FlorianBaumgartner/WallLight/Bootloader/Flash-Offsets.PNG

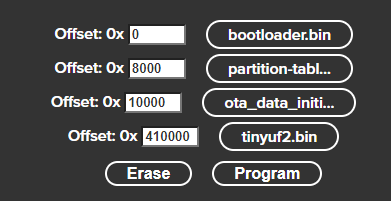
Bootloader/Flash-Offsets.PNG
