FlorianBaumgartner/WallLight/Software/flowpy/.assets/Flowpy_studio_example_flow.png

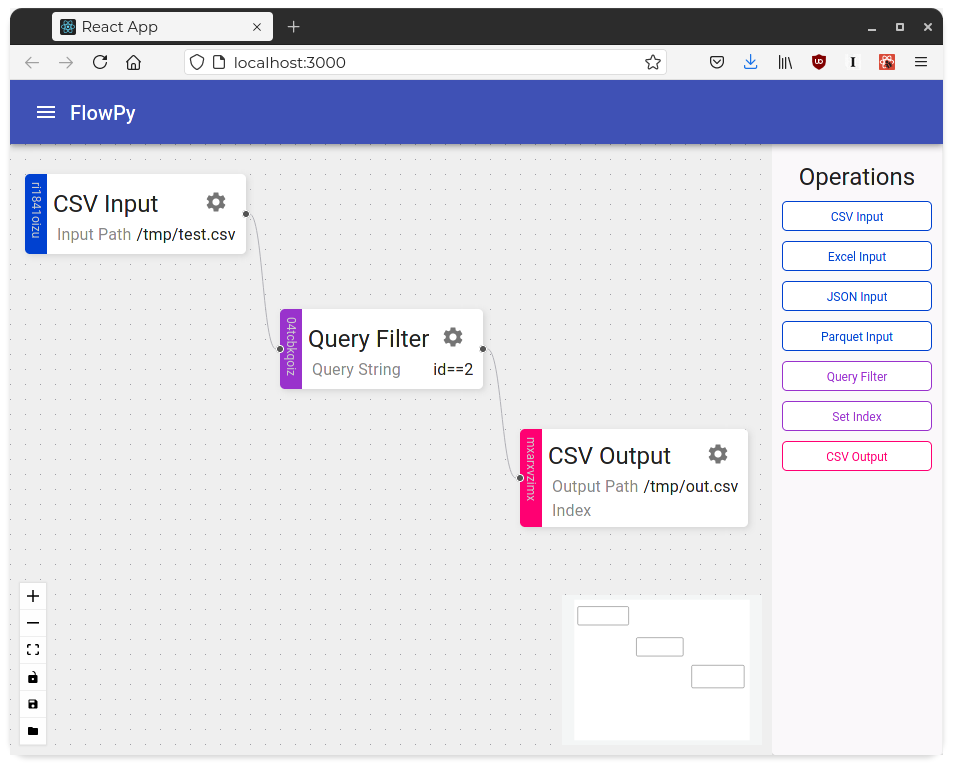
Software/flowpy/.assets/Flowpy_studio_example_flow.png
