FlorianBaumgartner/WallLight/Software/flowpy/.assets/Flowpy_studio_example_flows_list.png

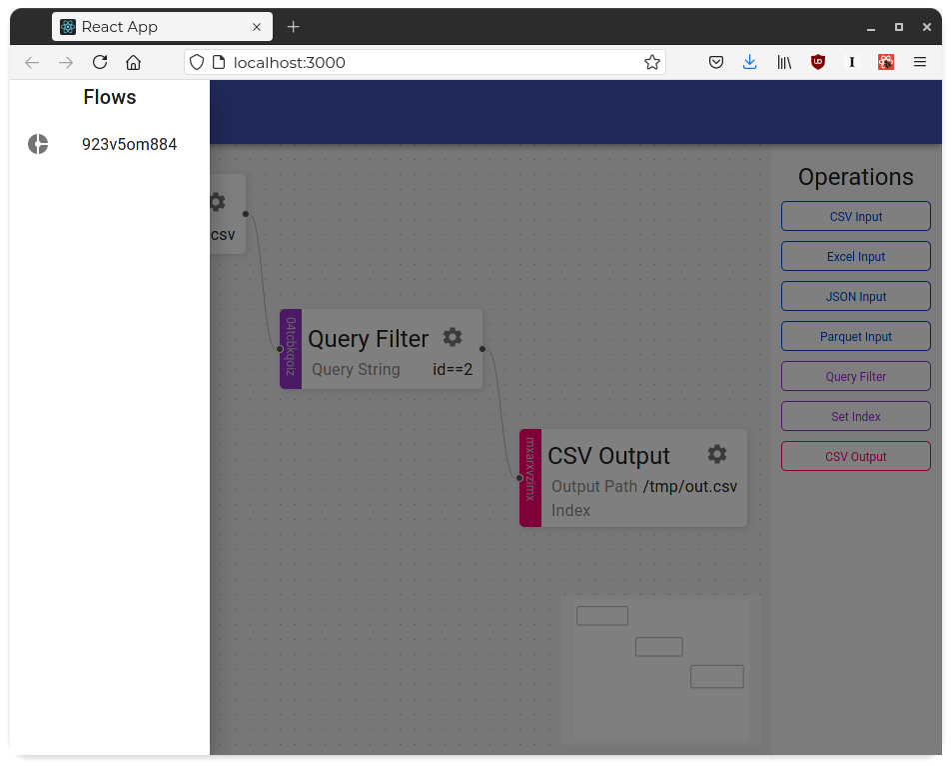
Software/flowpy/.assets/Flowpy_studio_example_flows_list.png
