FlorianBaumgartner/WallLight/Software/flowpy/.assets/Flowpy_studio_example_params.png

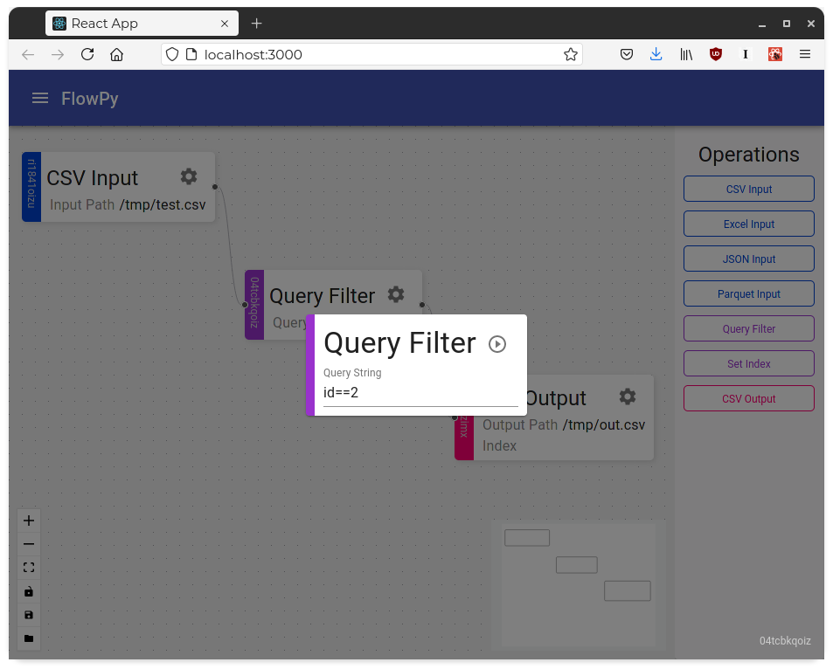
Software/flowpy/.assets/Flowpy_studio_example_params.png
