FlorianBaumgartner/WallLight/Software/flowpy/.assets/prealpha_api_node_run.png

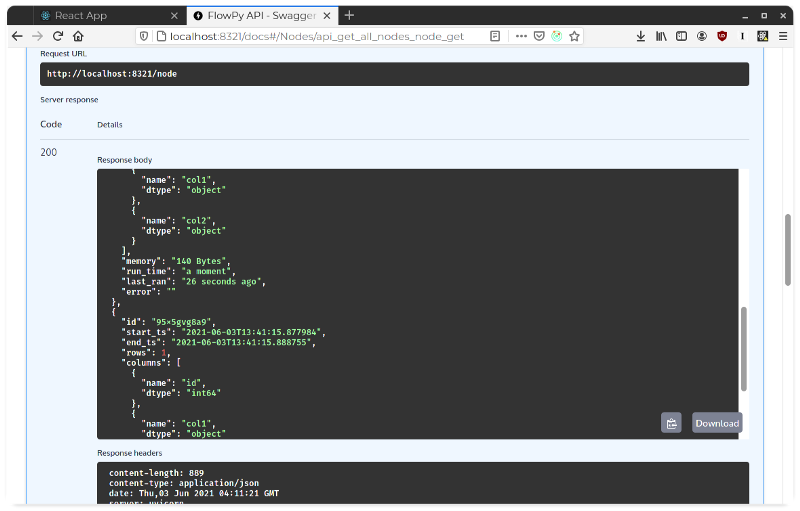
Software/flowpy/.assets/prealpha_api_node_run.png
