FlorianBaumgartner/WallLight/Software/flowpy/.assets/prealpha_ui.png

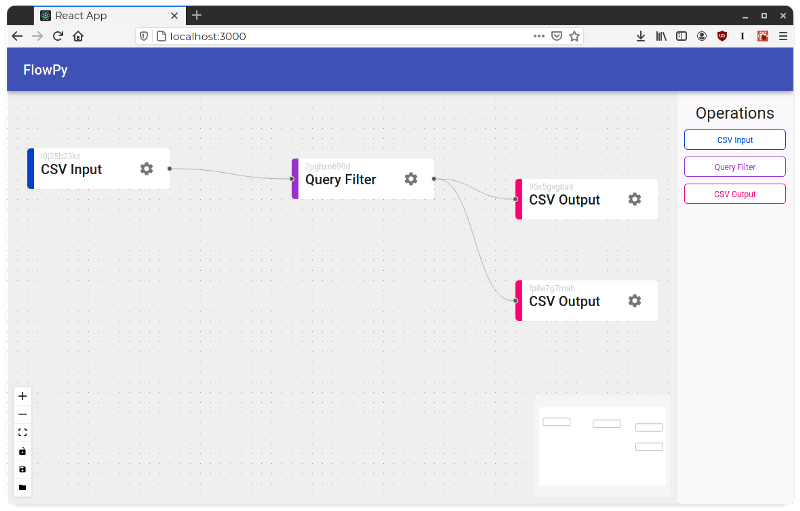
Software/flowpy/.assets/prealpha_ui.png
