FlorianBaumgartner/WallLight/Software/flowpy/.assets/prealpha_ui_node_settings.png

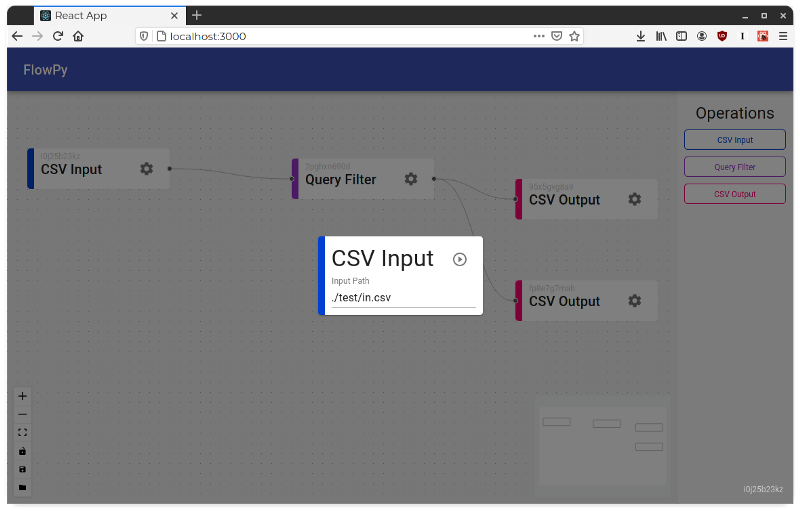
Software/flowpy/.assets/prealpha_ui_node_settings.png
