FlorianBaumgartner/WallLight/Software/TeensyGui/img/adat.jpg

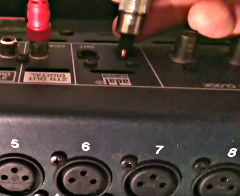
Software/TeensyGui/img/adat.jpg
