FlorianBaumgartner/WallLight/Software/TeensyGui/img/adccircuit2.png

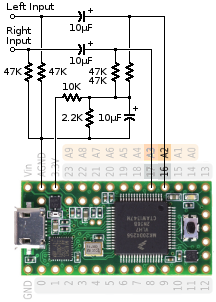
Software/TeensyGui/img/adccircuit2.png
