FlorianBaumgartner/WallLight/Software/TeensyGui/img/adccircuit.png

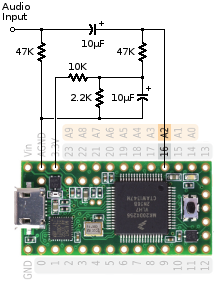
Software/TeensyGui/img/adccircuit.png
