FlorianBaumgartner/WallLight/Software/TeensyGui/img/adccircuitmic.jpg

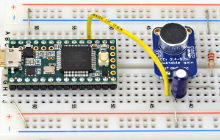
Software/TeensyGui/img/adccircuitmic.jpg
