FlorianBaumgartner/WallLight/Software/TeensyGui/img/adcpins1.jpg

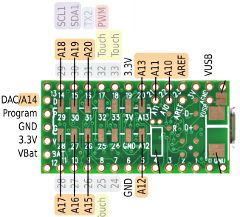
Software/TeensyGui/img/adcpins1.jpg
