FlorianBaumgartner/WallLight/Software/TeensyGui/img/adcpins2.jpg

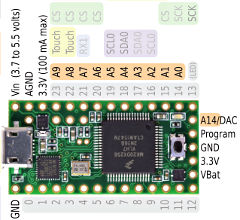
Software/TeensyGui/img/adcpins2.jpg
