FlorianBaumgartner/WallLight/Software/TeensyGui/img/ampschematics.png

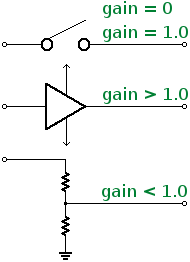
Software/TeensyGui/img/ampschematics.png
