FlorianBaumgartner/WallLight/Software/TeensyGui/img/audioshield_backside.jpg

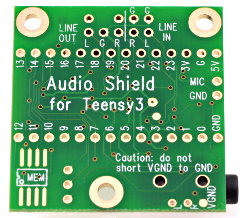
Software/TeensyGui/img/audioshield_backside.jpg
