FlorianBaumgartner/WallLight/Software/TeensyGui/img/audioshield_inputs.jpg

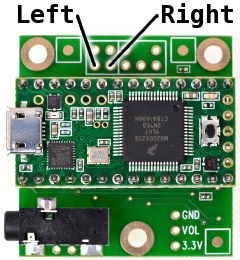
Software/TeensyGui/img/audioshield_inputs.jpg
