FlorianBaumgartner/WallLight/Software/TeensyGui/img/audioshield_outputs.jpg

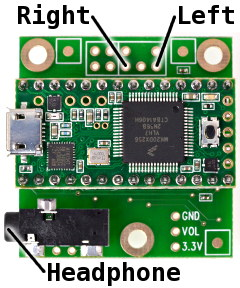
Software/TeensyGui/img/audioshield_outputs.jpg
