FlorianBaumgartner/WallLight/Software/TeensyGui/img/audioshield_quad_in.jpg

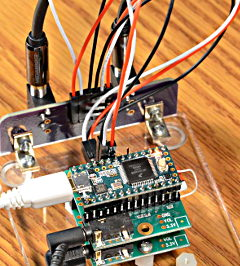
Software/TeensyGui/img/audioshield_quad_in.jpg
