FlorianBaumgartner/WallLight/Software/TeensyGui/img/audioshield_quad_out.jpg

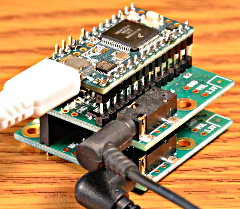
Software/TeensyGui/img/audioshield_quad_out.jpg
