FlorianBaumgartner/WallLight/Software/TeensyGui/img/biquad.png

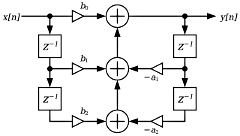
Software/TeensyGui/img/biquad.png
