FlorianBaumgartner/WallLight/Software/TeensyGui/img/cs42448.jpg

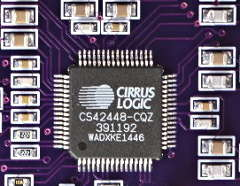
Software/TeensyGui/img/cs42448.jpg
