FlorianBaumgartner/WallLight/Software/TeensyGui/img/dac_speaker.jpg

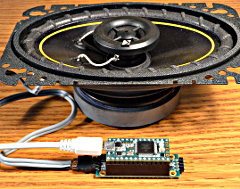
Software/TeensyGui/img/dac_speaker.jpg
