FlorianBaumgartner/WallLight/Software/TeensyGui/img/dacpin.jpg

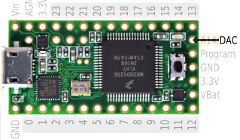
Software/TeensyGui/img/dacpin.jpg
