FlorianBaumgartner/WallLight/Software/TeensyGui/img/dacpins.png

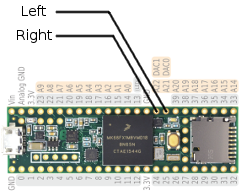
Software/TeensyGui/img/dacpins.png
