FlorianBaumgartner/WallLight/Software/TeensyGui/img/dahdsr.png

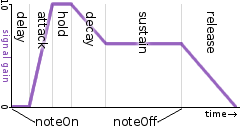
Software/TeensyGui/img/dahdsr.png
