FlorianBaumgartner/WallLight/Software/TeensyGui/img/delay.png

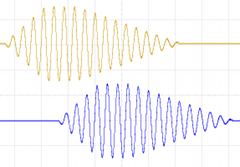
Software/TeensyGui/img/delay.png
