FlorianBaumgartner/WallLight/Software/TeensyGui/img/ladder.png

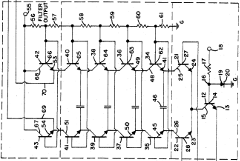
Software/TeensyGui/img/ladder.png
