FlorianBaumgartner/WallLight/Software/TeensyGui/img/memoryboard.jpg

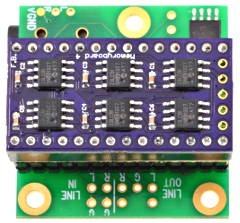
Software/TeensyGui/img/memoryboard.jpg
