FlorianBaumgartner/WallLight/Software/TeensyGui/img/multiply.png

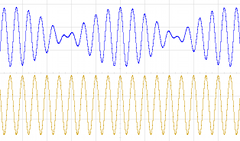
Software/TeensyGui/img/multiply.png
