FlorianBaumgartner/WallLight/Software/TeensyGui/img/pt8211.jpg

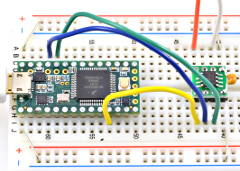
Software/TeensyGui/img/pt8211.jpg
