FlorianBaumgartner/WallLight/Software/TeensyGui/img/pwm.png

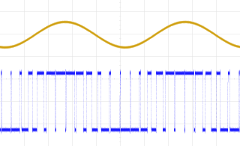
Software/TeensyGui/img/pwm.png
