FlorianBaumgartner/WallLight/Software/TeensyGui/img/pwmdualcircuit.jpg

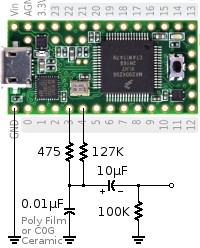
Software/TeensyGui/img/pwmdualcircuit.jpg
