FlorianBaumgartner/WallLight/Software/TeensyGui/img/sgtl5000closeup.jpg

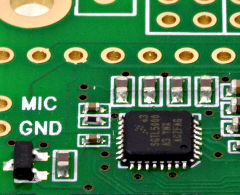
Software/TeensyGui/img/sgtl5000closeup.jpg
