FlorianBaumgartner/WallLight/Software/TeensyGui/img/shelf_filter.png

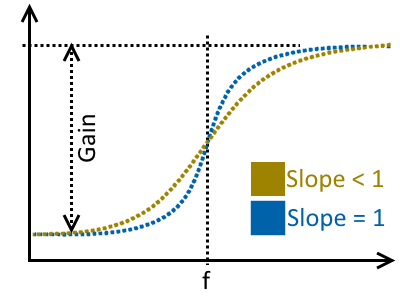
Software/TeensyGui/img/shelf_filter.png
