FlorianBaumgartner/WallLight/Software/TeensyGui/img/spdif_proto.jpg

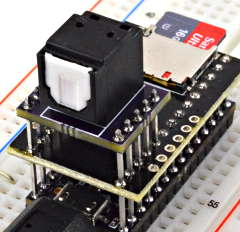
Software/TeensyGui/img/spdif_proto.jpg
