FlorianBaumgartner/WallLight/Software/TeensyGui/img/tdm.jpg

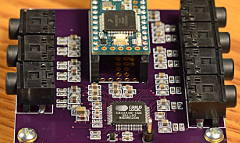
Software/TeensyGui/img/tdm.jpg
