FlorianBaumgartner/WallLight/Software/TeensyGui/img/touchguitar.jpg

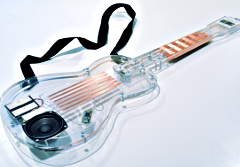
Software/TeensyGui/img/touchguitar.jpg
