FlorianBaumgartner/WallLight/Software/TeensyGui/img/usbtype_audio.png

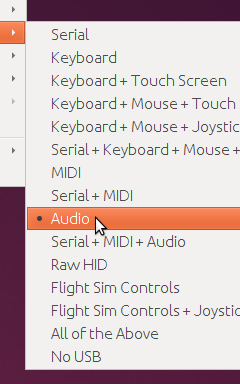
Software/TeensyGui/img/usbtype_audio.png
