FlorianBaumgartner/WallLight/Software/TeensyGui/img/usbtype_audio_in.png

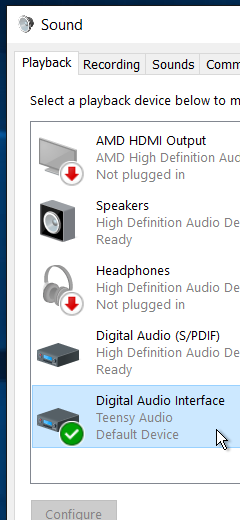
Software/TeensyGui/img/usbtype_audio_in.png
