FlorianBaumgartner/WallLight/Software/TeensyGui/img/usbtype_audio_out.png

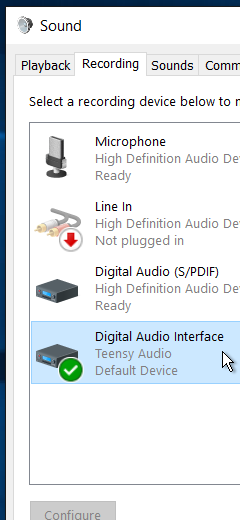
Software/TeensyGui/img/usbtype_audio_out.png
