FlorianBaumgartner/WallLight/Software/TeensyGui/img/w25q128fv.jpg

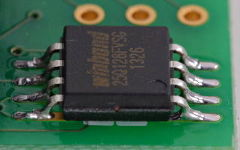
Software/TeensyGui/img/w25q128fv.jpg
