FlorianBaumgartner/WallLight/Software/TeensyGui/img/wavefolder.png

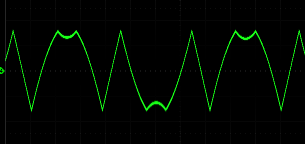
Software/TeensyGui/img/wavefolder.png
