FlorianBaumgartner/WallLight/Software/TeensyGui/img/waveforms.png

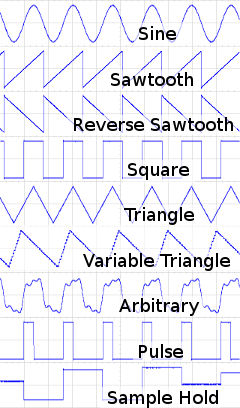
Software/TeensyGui/img/waveforms.png
