FlorianBaumgartner/WallLight/Software/TeensyGui/img/waveformsmod.png

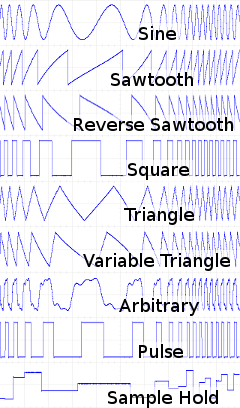
Software/TeensyGui/img/waveformsmod.png
