FlorianBaumgartner/WallLight/Software/TeensyGui/img/waveshaper.png

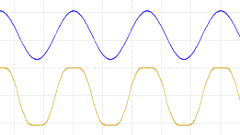
Software/TeensyGui/img/waveshaper.png
