FlorianBaumgartner/WallLight/Software/TeensyGui/img/wavetablevideo.jpg

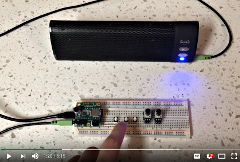
Software/TeensyGui/img/wavetablevideo.jpg
