FlorianBaumgartner/WallLight/Hardware/WallLightRemote/Project Logs for WallLightRemote/WallLightRemote_V1.0 BOM.xlsx

Comment | Designator | Footprint | LCSC Part Number
SLDA72-2R470G-S1TF (2.47GHz) | A1 | SMD Chip-Antenna 7020 (SLDA72-2R470G-S1TF) | C370399
100µF 6.3V | C1, C26, C29 | SMD Tantalkondensator 1210 + | C16133
10µF 50V | C2, C20, C21, C23, C25, C28, C31, C44 | SMD Keramikkondensator 1206 | C13585
1µF 50V | C3, C4, C5, C6, C7, C8, C9, C14, C16, C17, C18, C22, C35, C36, C37, C38, C39, C40, C41, C42, C43 | SMD Keramikkondensator 0603 | C15849
1pF 50V | C10, C11 | SMD Keramikkondensator 0402 | C161149
15pF 50V | C12, C13 | SMD Keramikkondensator 0603 | C1644
100nF 50V | C15, C19, C24, C32, C33, C45, C46, C47, C48, C49 | SMD Keramikkondensator 0603 | C14663
27pF 50V | C27 | SMD Keramikkondensator 0603 | C107045
10nF 50V | C30, C34 | SMD Keramikkondensator 0603 | C57112
PD4E1U06 | D1 | SMD IC SOT-363 (SC-70-6) | C194628
B5819W | D2, D3, D4, D5 | SMD Diode SOD-123 | C8598
LBSS84LT1G | K1, K3, K6 | SMD MOSFET SOT-23 | C8492
AO3401A | K2, K4, K5, K8, K9 | SMD MOSFET SOT-23 | C15127
2N7002 | K7 | SMD MOSFET SOT-23 | C8545
2.2nH | L1 | SMD Inductor 0402 | C918998
LQH32PN4R7NN0L (4.7µH, 1.0A) | L2 | SMD Inductor 3.2x2.5x1.7 | C98021
Red (5mA, 2.0V) | P1 | SMD LED 0603 | C2286
40Mhz | Q1 | SMD Crystal 2.5X2.0X0.5 | C524681
10k (75V, 100mW, 1%) | R1, R2, R19, R29, R30, R33, R34, R43, R44, R45 | SMD Widerstand 0603 | C25804
5.1k (75V, 100mW, 1%) | R3, R4 | SMD Widerstand 0603 | C23186
1M (75V, 100mW, 1%) | R5 | SMD Widerstand 0603 | C22935
1k (75V, 100mW, 1%) | R6, R9 | SMD Widerstand 0603 | C21190
100k (75V, 100mW, 1%) | R7, R8, R13, R16 | SMD Widerstand 0603 | C25803
1.2k (75V, 100mW, 1%) | R10 | SMD Widerstand 0603 | C22765
330k (75V, 100mW, 1%) | R11, R12, R14, R15, R18, R20 | SMD Widerstand 0603 | C23137
22k (75V, 100mW, 1%) | R17 | SMD Widerstand 0603 | C31850
68 (75V, 100mW, 1%) | R21, R22, R23, R24, R25, R26, R27, R28 | SMD Widerstand 0603 | C27592
10k (4x, 50V, 62.5mW, 5%) | R31, R35, R36, R37, R38, R39, R40, R41, R42 | SMD Widerstand Array 4-Fach 0603 | C29718
68 (4x, 50V, 62.5mW, 5%) | R32 | SMD Widerstand Array 4-Fach 0603 | C25513
SKRPACE010 | S1, S2 | SMD Button 4.2x3.2x2.5 | C139797
EVQQ2U02W | S3, S4, S5, S6, S7, S8, S9, S10, S11, S12, S13, S14, S15, S16, S17, S18, S19 | SMD Button 6.5x6.0x2.5 | C395227
TS-1003S-07026 | S24, S26 | SMD Button 12.0x12.0x7.5 | C455223
SS-12D10-G050 | S25, S27 | THT Slide Switch (MS12ANG03) | C2848933
VEML6040 | U2 | SMD Color Sensor (VEML6040) | C78465
MP34DT06JTR | U3 | SMD Microphone (MP34DT06JTR) | C503097
TP4054 | U4 | SMD IC SOT-23-5 | C32574
RY2200 | U5 | SMD IC SOT-23-3 | C2888102
TD6811 | U6 | SMD IC SOT-23-5 | C189486
TC7W74FU | U7 | SMD IC TSSOP-8 | C128631
74HC138D | U8 | SMD IC SOIC-16 | C5205140
SN74HCS165 | U9, U10, U11, U12 | SMD IC WQFN-16 (3.5x2.5) | C2866439
USB4105-GF-A | X1 | SMD USB-C Socket (A40-00119) | C167321
