FlorianBaumgartner/WallLight/Hardware/WallLightRemote/3D/SF-TC190B-8822A/SF-TC190B-8822A.SLDASM

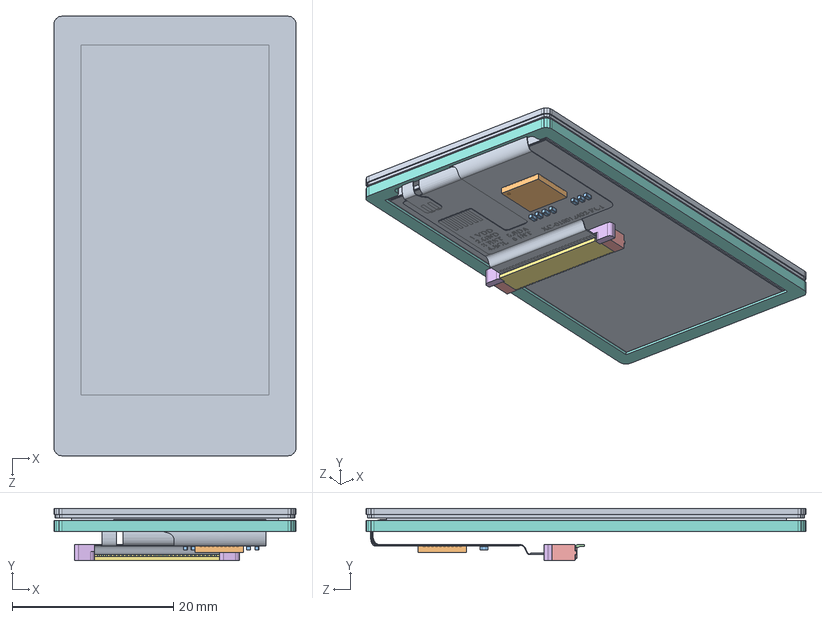
[picture p49: CAD file, 2023-07-22]
Hardware/WallLightRemote/3D/SF-TC190B-8822A/SF-TC190B-8822A.SLDASM
30.0 x 6.50 x 54.5 mm
SF-TC190B-8822A
User Library-QFN40
Broche P281 H.stp x 30
Partie métallique P281.stp x 2
Capot P281-C-1R.stp
Isolant P281-C-1R.stp
Spacer
