FlorianBaumgartner/WallLight/Hardware/WallLightRemote/3D/SF-TC190B-8822A/SF-TC190B-8822A_Main_Cable.dxf

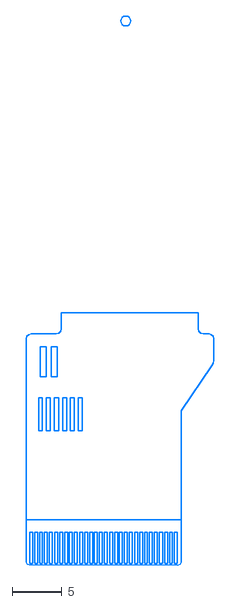
[picture p50: CAD file, 2023-07-02]
Hardware/WallLightRemote/3D/SF-TC190B-8822A/SF-TC190B-8822A_Main_Cable.dxf
18.8 x 55.0
