FlorianBaumgartner/WallLight/Hardware/WallLight/3D/7790.step

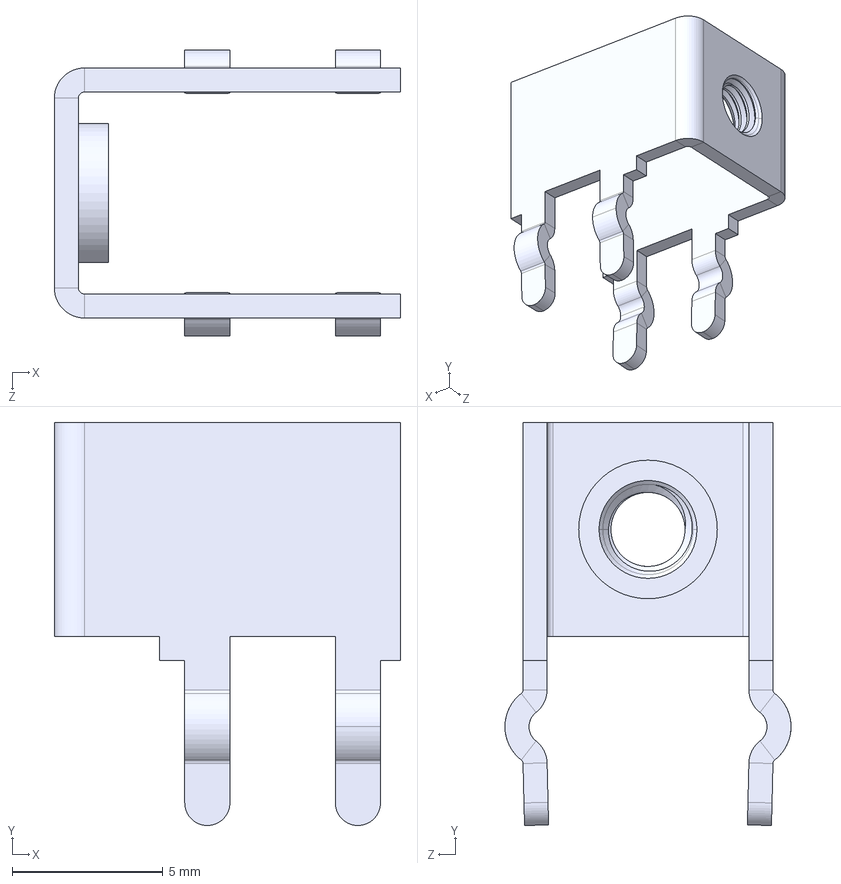
[picture p51: CAD file, 2024-01-29]
Hardware/WallLight/3D/7790.step
11.5 x 13.4 x 9.50 mm
