FlorianBaumgartner/WallLight/Hardware/WallLightRemote/3D/Encoder.step

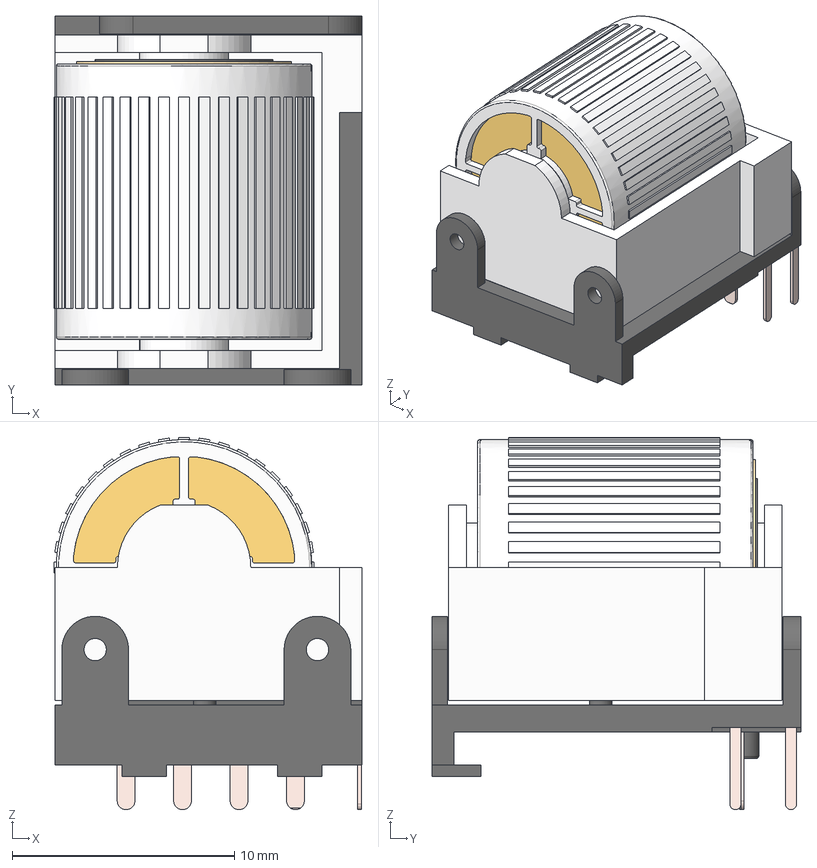
[picture p52: CAD file, 2023-07-02]
Hardware/WallLightRemote/3D/Encoder.step
13.9 x 16.6 x 16.8 mm
Plastic
Barrel in
Cap
Barrel out
Leg (1)
housing
Leg (2)
Leg (3)
Plastic (1)
Leg
Leg (4)
Leg (5)
