FlorianBaumgartner/WallLight/Hardware/WallLightRemote/3D/N085-1212TBWIG41/N085-1212TBWIG41.SLDPRT

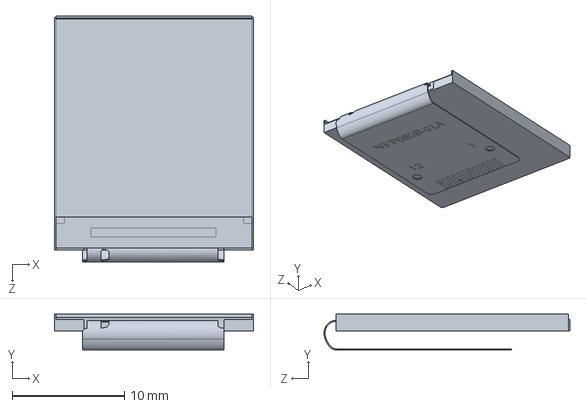
[picture p53: CAD file, 2023-07-02]
Hardware/WallLightRemote/3D/N085-1212TBWIG41/N085-1212TBWIG41.SLDPRT
17.7 x 3.20 x 21.9 mm
