FlorianBaumgartner/WallLight/Hardware/WallLightRemote/3D/SLDA72-2R470G-S1TF/SLDA72-2R470G-S1TF.SLDPRT

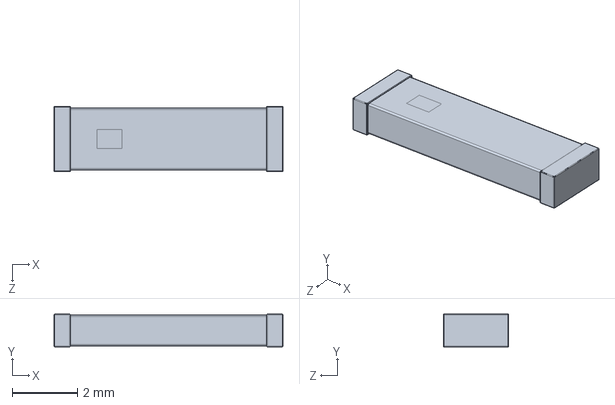
[picture p54: CAD file, 2023-07-02]
Hardware/WallLightRemote/3D/SLDA72-2R470G-S1TF/SLDA72-2R470G-S1TF.SLDPRT
7.00 x 1.00 x 2.00 mm
