FlorianBaumgartner/WallLight/Hardware/WallLightRemote/3D/SF-TC190B-8822A/Spacer.SLDPRT

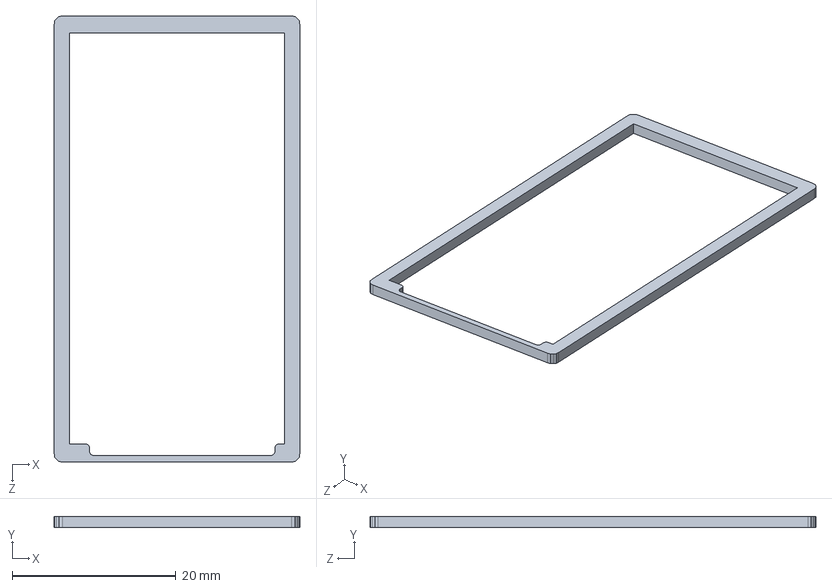
[picture p55: CAD file, 2023-07-22]
Hardware/WallLightRemote/3D/SF-TC190B-8822A/Spacer.SLDPRT
30.0 x 1.40 x 54.5 mm
