FlorianBaumgartner/WallLight/Hardware/WallLightRemote/3D/SS-12D10L4.STEP

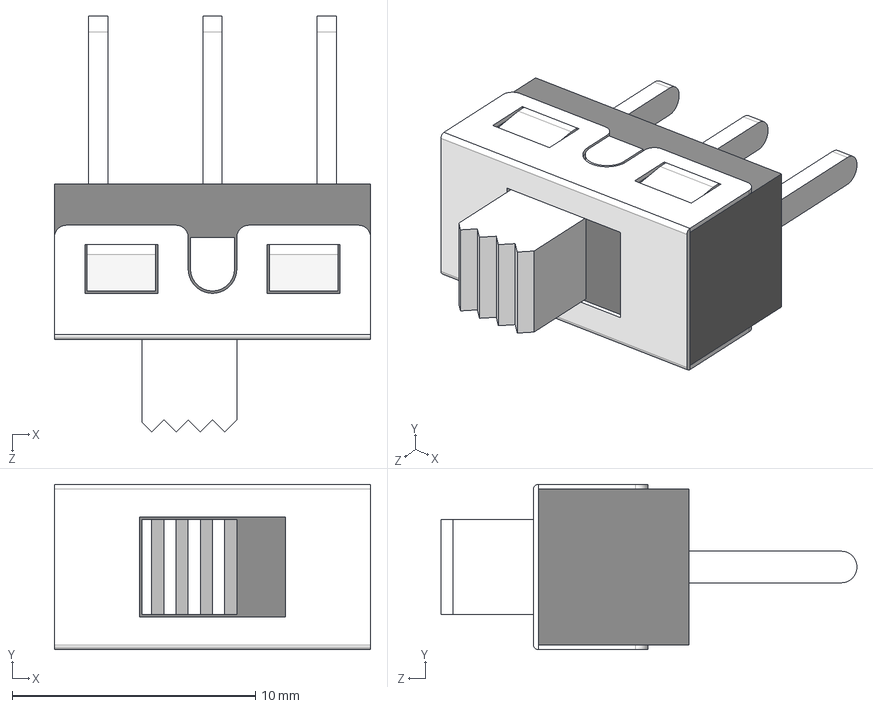
[picture p56: CAD file, 2023-07-02]
Hardware/WallLightRemote/3D/SS-12D10L4.STEP
13.0 x 6.80 x 17.1 mm
