FlorianBaumgartner/WallLight/Hardware/WallLightRemote/3D/SF-TC190B-8822A/SF-TC190B-8822A_Touch_Cable.dxf

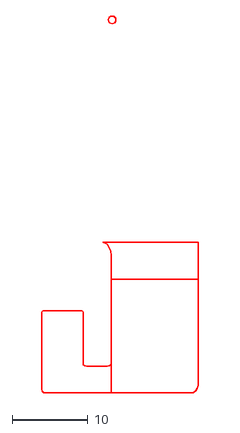
[picture p57: CAD file, 2023-07-02]
Hardware/WallLightRemote/3D/SF-TC190B-8822A/SF-TC190B-8822A_Touch_Cable.dxf
20.6 x 49.6
