FlorianBaumgartner/WallLight/Hardware/WallLightRemote/3D/SKRPAC.STEP

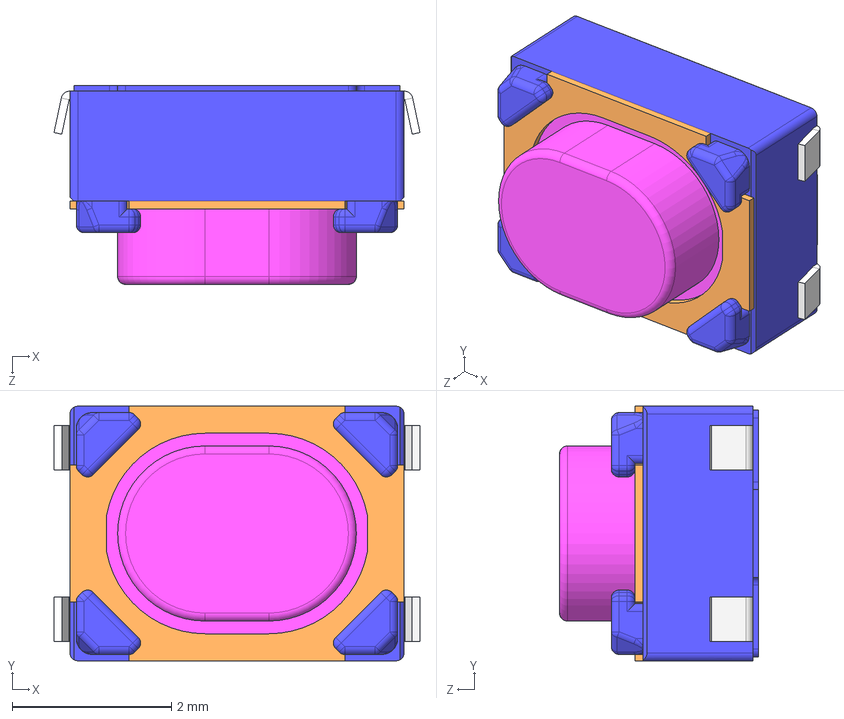
[picture p58: CAD file, 2023-07-02]
Hardware/WallLightRemote/3D/SKRPAC.STEP
4.60 x 3.20 x 2.50 mm
