FlorianBaumgartner/WallLight/Hardware/WallLightRemote/3D/Tactal Switch - SMD (12mmx12mmx7.5mm).stp

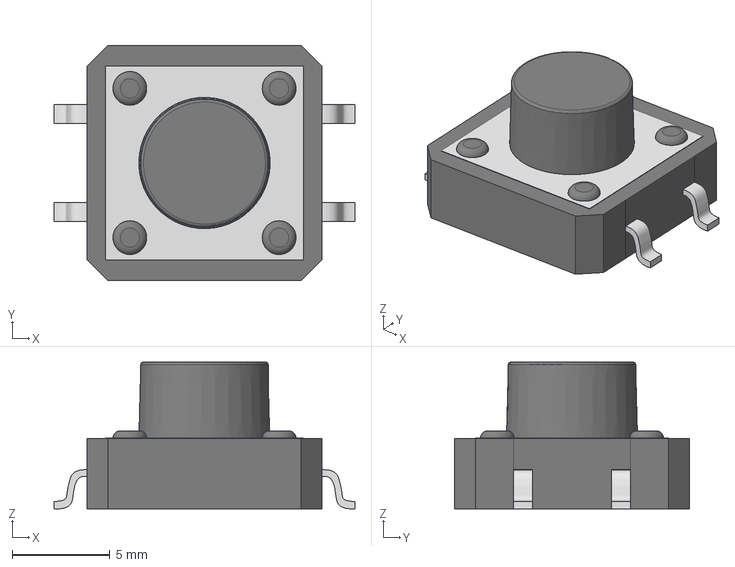
[picture p59: CAD file, 2023-07-02]
Hardware/WallLightRemote/3D/Tactal Switch - SMD (12mmx12mmx7.5mm).stp
15.4 x 12.0 x 7.50 mm
