FlorianBaumgartner/WallLight/Hardware/WallLightRemote/3D/SF-TC190B-8822A/User Library-QFN40.SLDPRT

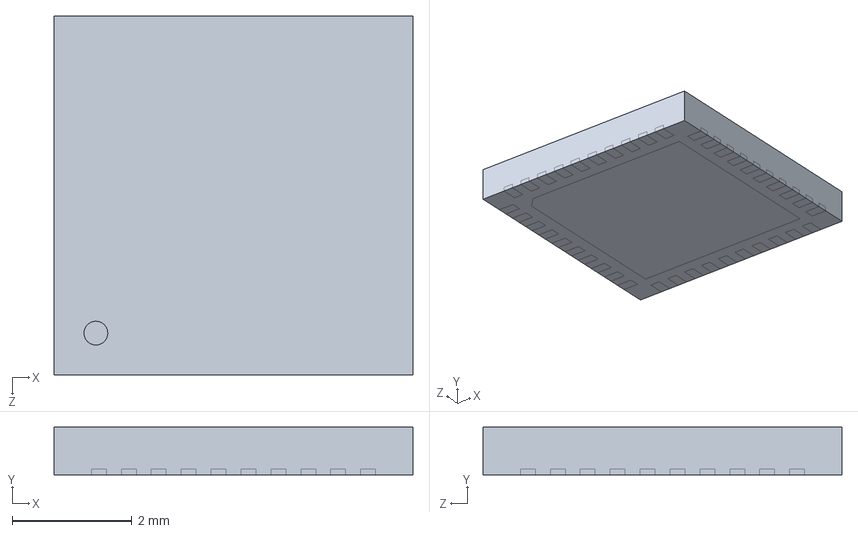
[picture p60: CAD file, 2023-07-02]
Hardware/WallLightRemote/3D/SF-TC190B-8822A/User Library-QFN40.SLDPRT
6.00 x 0.8 x 6.00 mm
