FlorianBaumgartner/WallLight/Hardware/WallLightRemote/3D/SW3x4_L.STEP

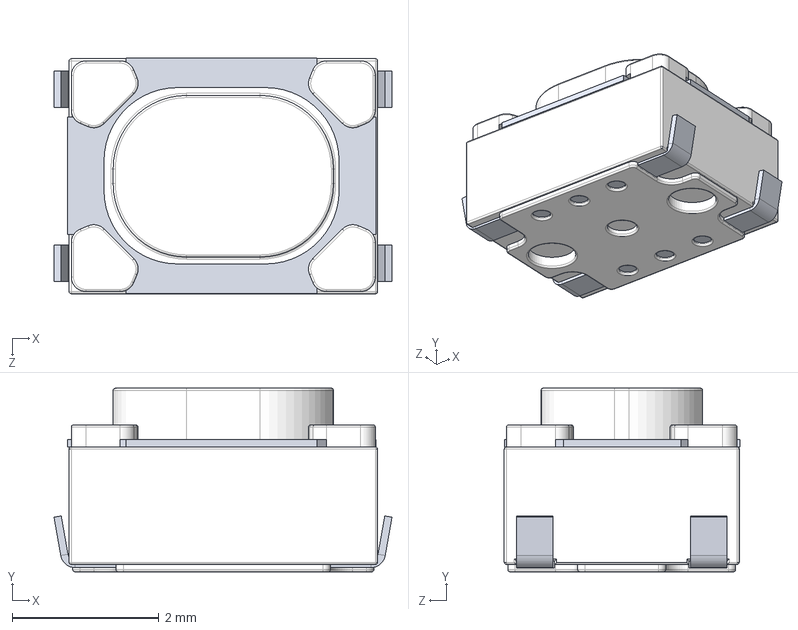
[picture p61: CAD file, 2023-07-02]
Hardware/WallLightRemote/3D/SW3x4_L.STEP
4.60 x 2.50 x 3.21 mm
sw3x4
sw3x4_cap
sw3x4_cover
sw3x4_hold
sw3x4_pin x 2
噩砃sw3x4_hold x 2
镜向镜向sw3x4_hold
