FlorianBaumgartner/WallLight/Hardware/WallLightRemote/3D/ESP32-S3-QFN56-77-44.STEP

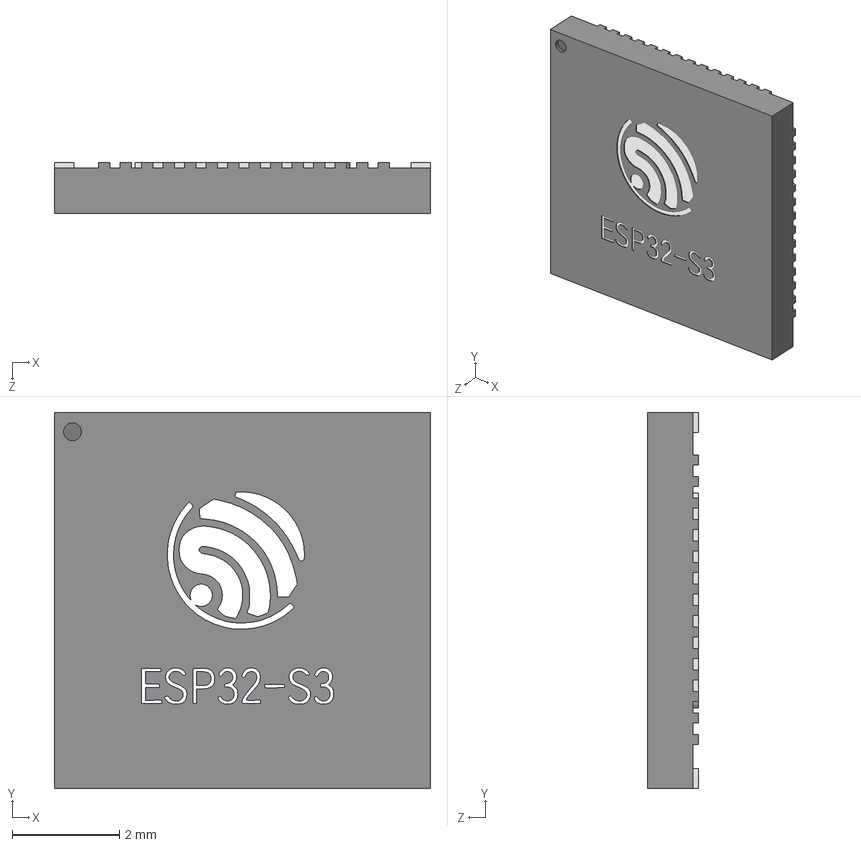
[picture p62: CAD file, 2023-07-02]
Hardware/WallLightRemote/3D/ESP32-S3-QFN56-77-44.STEP
7.00 x 7.00 x 0.95 mm
