FlorianBaumgartner/WallLight/Hardware/WallLightRemote/3D/SF-TC190B-8822A/SF-TC190B-8822A_LED_Cable.dxf

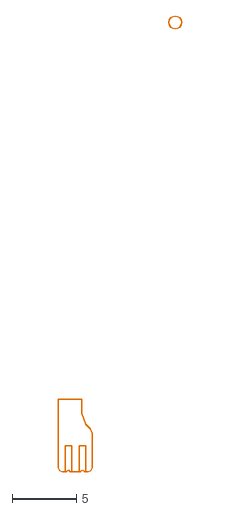
[picture p63: CAD file, 2023-07-02]
Hardware/WallLightRemote/3D/SF-TC190B-8822A/SF-TC190B-8822A_LED_Cable.dxf
9.55 x 35.4
