FlorianBaumgartner/WallLight/Hardware/WallLightRemote/3D/SF-TC190B-8822A/SF-TC190B-8822A_Display.dxf

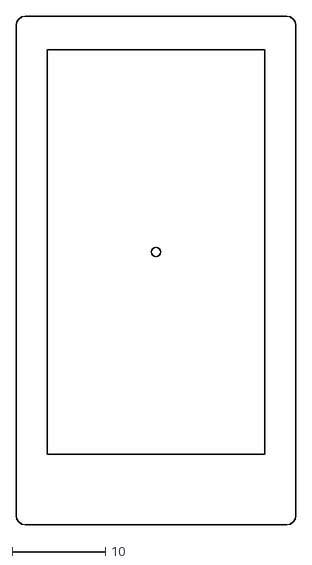
[picture p64: CAD file, 2023-07-02]
Hardware/WallLightRemote/3D/SF-TC190B-8822A/SF-TC190B-8822A_Display.dxf
30.0 x 54.5
