FlorianBaumgartner/WallLight/Hardware/WallLightRemote/3D/User Library-hclga_4l.SLDPRT

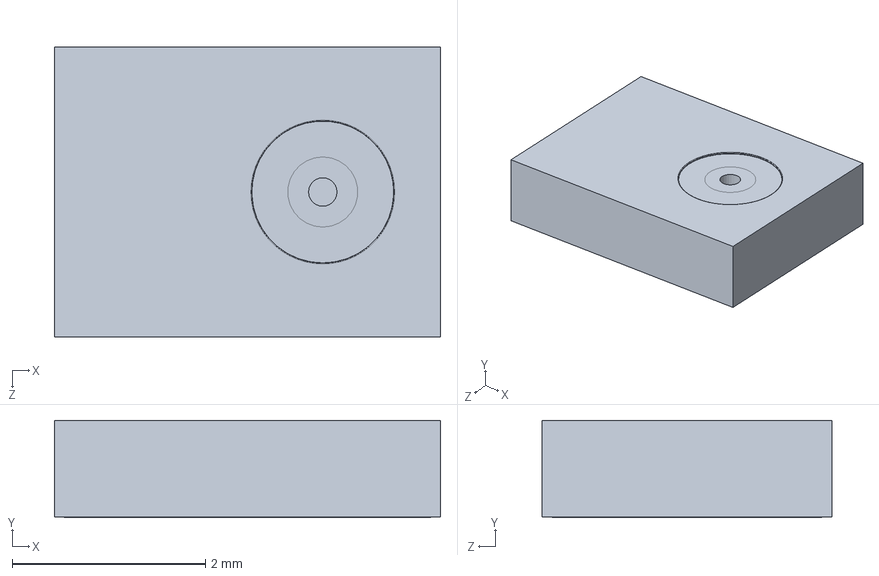
[picture p65: CAD file, 2023-07-02]
Hardware/WallLightRemote/3D/User Library-hclga_4l.SLDPRT
4.00 x 1.01 x 3.00 mm
