FlorianBaumgartner/WallLight/Hardware/WallLightRemote/3D/evqq2-dhmsw2-02w_.step

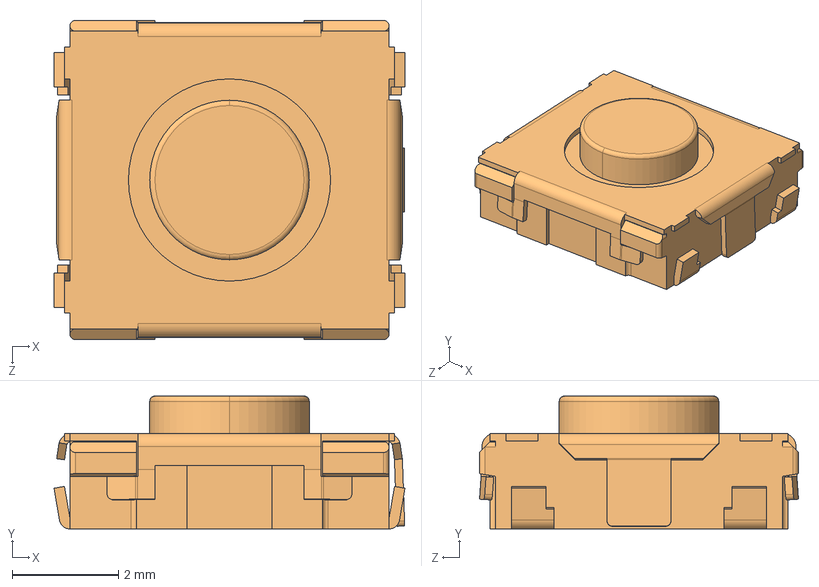
[picture p66: CAD file, 2023-07-02]
Hardware/WallLightRemote/3D/evqq2-dhmsw2-02w_.step
6.60 x 2.50 x 6.00 mm
