FlorianBaumgartner/WallLight/Hardware/WallLightRemote/3D/SF-TC190B-8822A/SF-TC190B-8822A-CT1_Drawing.dxf

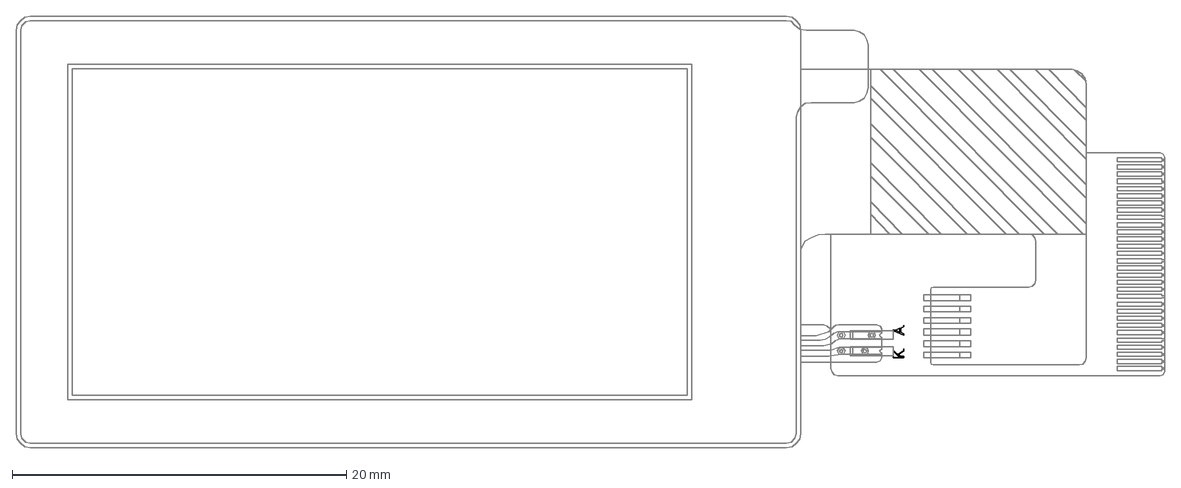
[picture p67: CAD file, 2023-07-02]
Hardware/WallLightRemote/3D/SF-TC190B-8822A/SF-TC190B-8822A-CT1_Drawing.dxf
68.7 x 25.8 mm
