FlorianBaumgartner/WallLight/(list of files, cad)

Other CAD files:
Hardware/WallLightRemote/3D/2520 SMD Crystal Oscillator.x_b
Hardware/WallLightRemote/3D/84593 VEML6040.SLDPRT
Hardware/WallLightRemote/3D/84593 VEML6040.stp
Hardware/WallLightRemote/3D/84593 VEML6040.x_t
Hardware/WallLightRemote/3D/Encoder.SLDASM
Hardware/WallLightRemote/3D/Encoder.x_t
Hardware/WallLightRemote/3D/N085-1212TBWIG41/N085-1212TBWIG41.dxf
Hardware/WallLightRemote/3D/N085-1212TBWIG41/N085-1212TBWIG41.x_t
Hardware/WallLightRemote/3D/SF-TC190B-8822A/20436_ACF-050-30-C-CMS-H.SLDASM
Hardware/WallLightRemote/3D/SF-TC190B-8822A/20436_ACF-050-30-C-CMS-H.stp
Hardware/WallLightRemote/3D/SF-TC190B-8822A/742843122.SLDPRT
Hardware/WallLightRemote/3D/SF-TC190B-8822A/742843122.x_t
Hardware/WallLightRemote/3D/SF-TC190B-8822A/SF-TC190B-8822A.SLDPRT
Hardware/WallLightRemote/3D/SF-TC190B-8822A/SF-TC190B-8822A.x_t
Hardware/WallLightRemote/3D/SF-TC190B-8822A/Spacer.STL
Hardware/WallLightRemote/3D/SF-TC190B-8822A/Spacer.x_t
Hardware/WallLightRemote/3D/SKRPAC.SLDPRT
Hardware/WallLightRemote/3D/SKRPAC.x_t
Hardware/WallLightRemote/3D/SLDA72-2R470G-S1TF/SLDA72-2R470G-S1TF.x_t
Hardware/WallLightRemote/3D/SS-12D10L4.SLDPRT
Hardware/WallLightRemote/3D/SS-12D10L4.x_t
Hardware/WallLightRemote/3D/Tactal Switch - SMD (12mmx12mmx7.5mm).SLDPRT
Hardware/WallLightRemote/3D/Tactal Switch - SMD (12mmx12mmx7.5mm).x_t
Hardware/WallLightRemote/3D/User Library-QFN56_0_4.x_t
Hardware/WallLightRemote/3D/User Library-WQFN-16.x_t
Hardware/WallLightRemote/3D/User Library-hclga_4l.x_t
Hardware/WallLightRemote/3D/evqq2-dhmsw2-02w_.SLDPRT
Hardware/WallLightRemote/3D/evqq2-dhmsw2-02w_.x_t
