FlorianBaumgartner/WallLight/Software/flowpy/test/in.csv

id | col1 | col2
0 | hello | world
1 | hell1 | worl1
2 | hell2 | worl2
3 | hell3 | worl3
4 | hell4 | worl4
5 | hell5 | worl5
