FlorianBaumgartner/WallLight/Software/flowpy/test/out.csv

id | col1 | col2
2 | hell2 | worl2
