FlorianBaumgartner/WallLight/Software/flowpy/test/out2.csv

 | id | col1 | col2
2 | 2 | hell2 | worl2
