FlorianBaumgartner/WallLight/Firmware/Testprograms/LED_Test/partitions_custom.csv

# Name | Type | SubType | Offset | Size | Flags
nvs | data | nvs | 0x009000 | 20K
otadata | data | ota | 0x00E000 | 8K
ota_0 | 0 | ota_0 | 0x010000 | 1408K
ota_1 | 0 | ota_1 | 0x170000 | 1408K
uf2 | app | factory | 0x2d0000 | 256K
ffat | data | fat | 0x310000 | 960K
# nvs | data | nvs | 0x9000 | 20K
# otadata | data | ota | 0xE000 | 8K
# app0 | app | ota_0 | 0x10000 | 2048K
# ffat | data | fat | 0x210000 | 1984K
