FlorianBaumgartner/WallLight/Hardware/WallLightRemote/WallLightRemote_V1.0.pdf

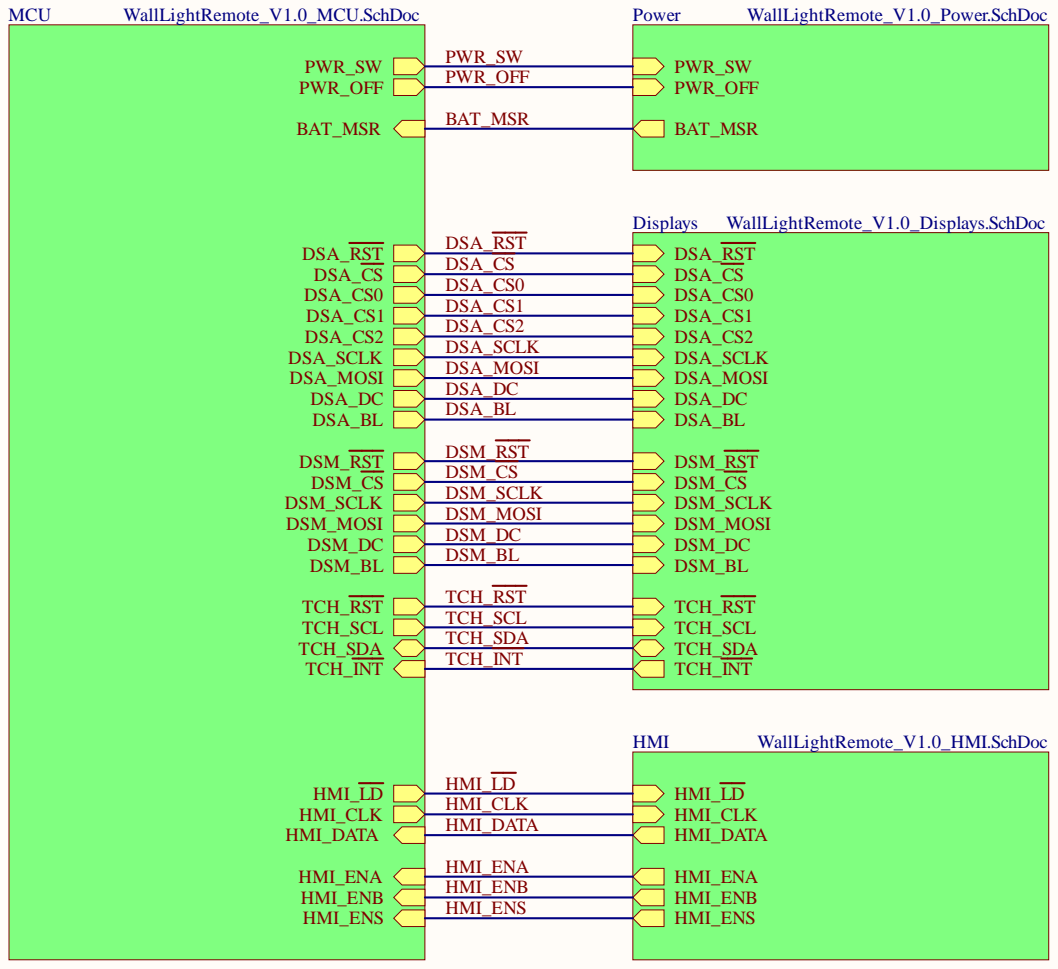
[picture p69: page 1]

Karl-Neuhaus-Strasse 6, 2502 Biel
florian.b-h@bluewin.ch

C:\Users\Admin\GoogleDrive\WallLight\Hardware\WallLightRemote\WallLightRemote_V1.0.SchDoc
File:

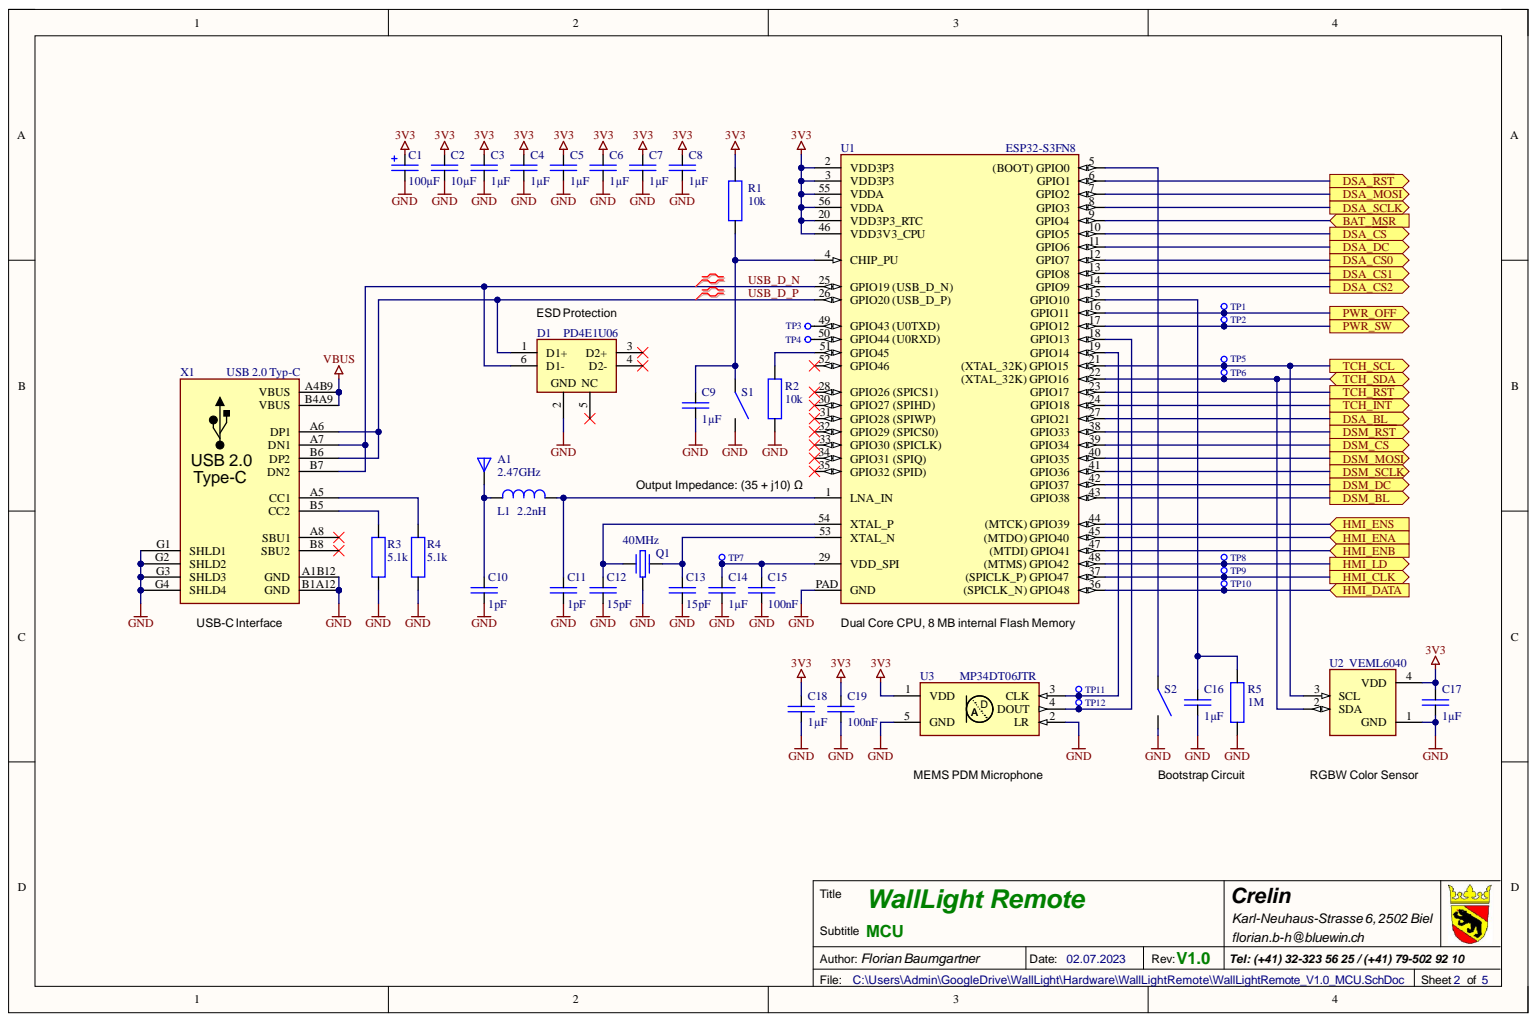
[picture p70: page 2]

5 5 | | 7
5 6 | | 8

2 0 | | 9
4 6 | | 1 0
4 | | 1 1

USB_ D _N 2 5 | | | 1 3

USB_ D _P | 2 6 | | 1 5

ESD Protec tion D 1 PD 4 E 1 U 0 6 | T P 3 T P 4 | 4 9 | | 1 6

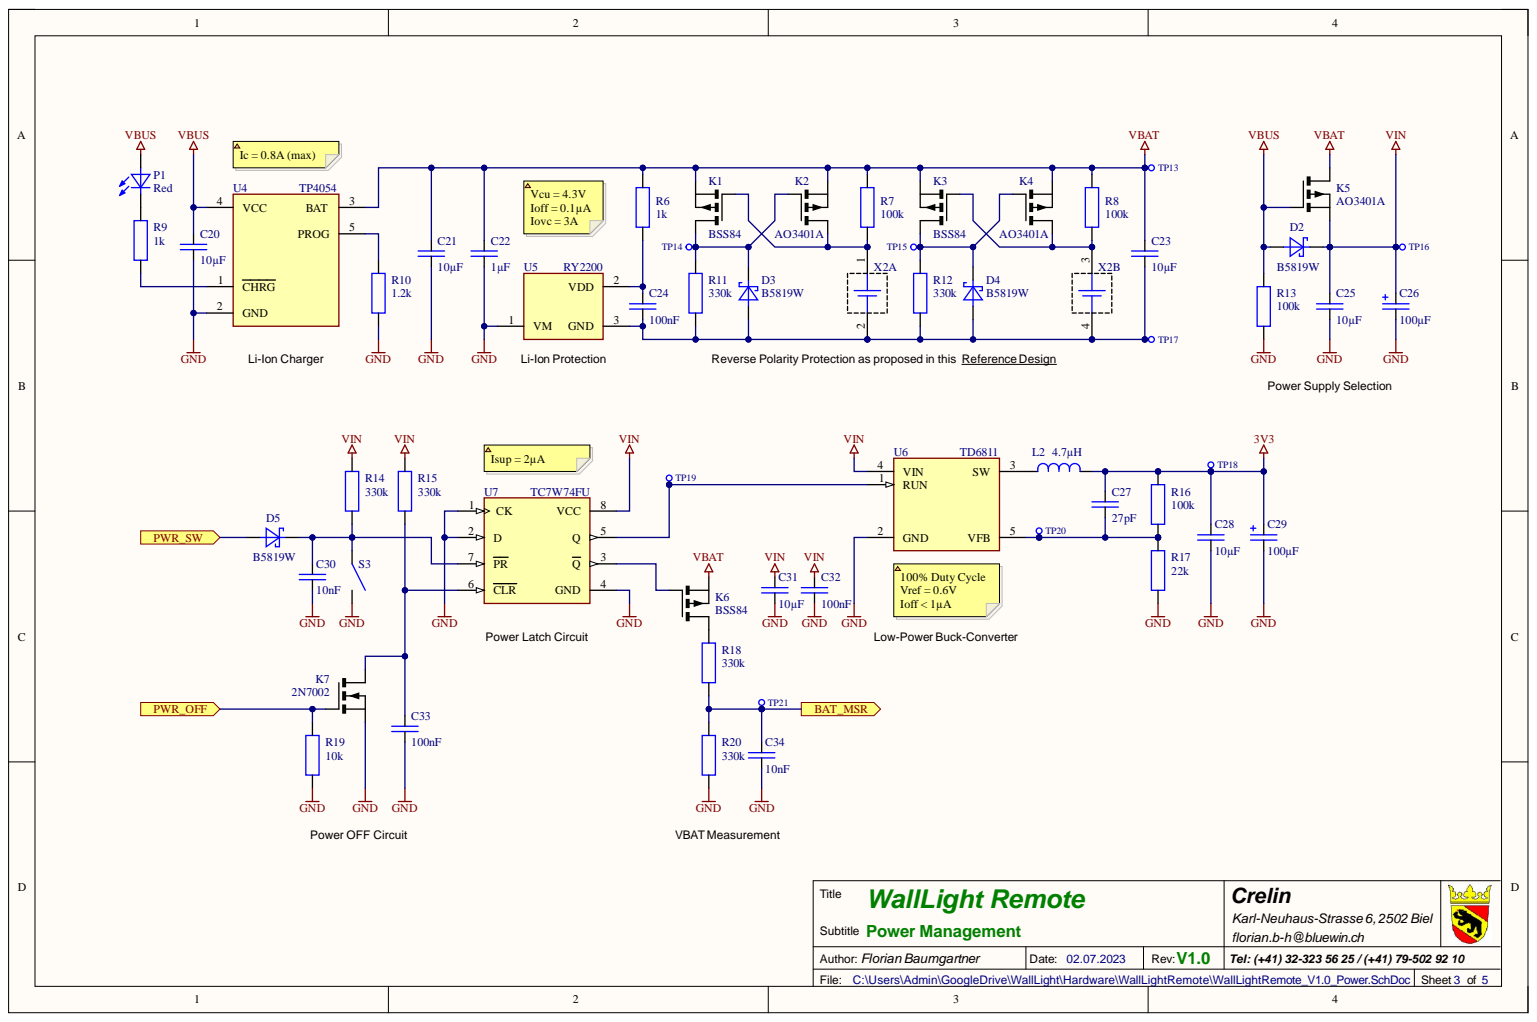
[picture p71: page 3]

CLR 6

GND
Low-Power Buck-Converter

Karl-Neuhaus-Strasse 6, 2502 Biel
florian.b-h@bluewin.ch

C:\Users\Admin\GoogleDrive\WallLight\Hardware\WallLightRemote\WallLightRemote_V1.0_Power.SchDoc
File:

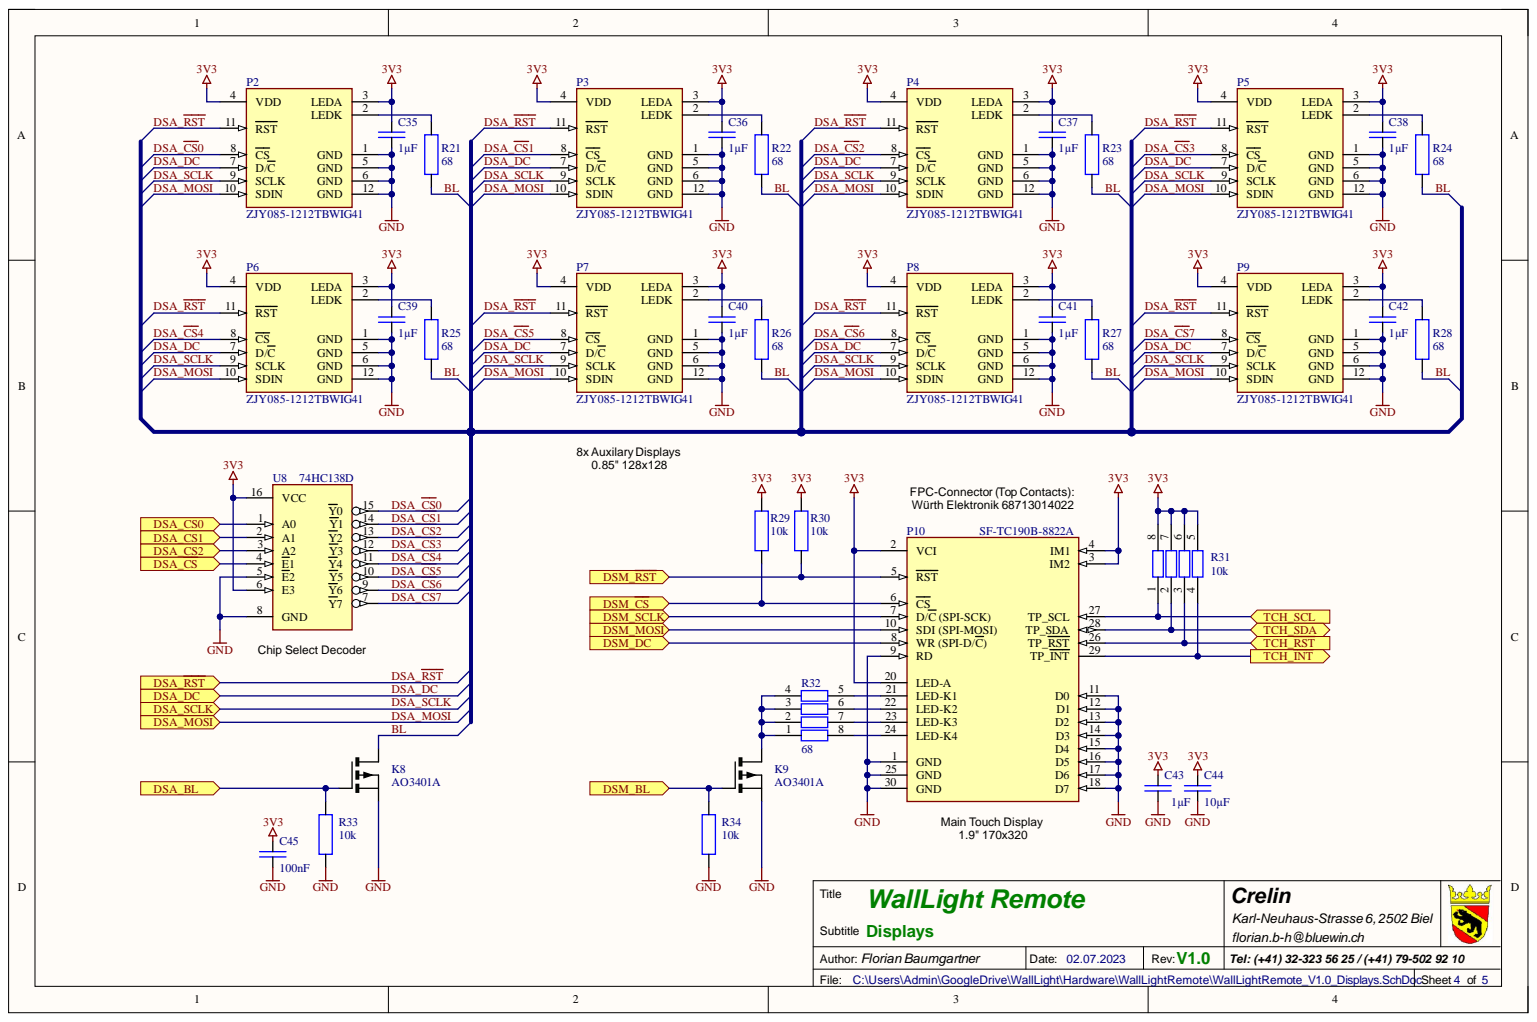
[picture p72: page 4]

FPC-Connector (Top Contacts):
Würth Elektronik 68713014022

Karl-Neuhaus-Strasse 6, 2502 Biel
florian.b-h@bluewin.ch

C:\Users\Admin\GoogleDrive\WallLight\Hardware\WallLightRemote\WallLightRemote_V1.0_Displays.SchDoc
File:

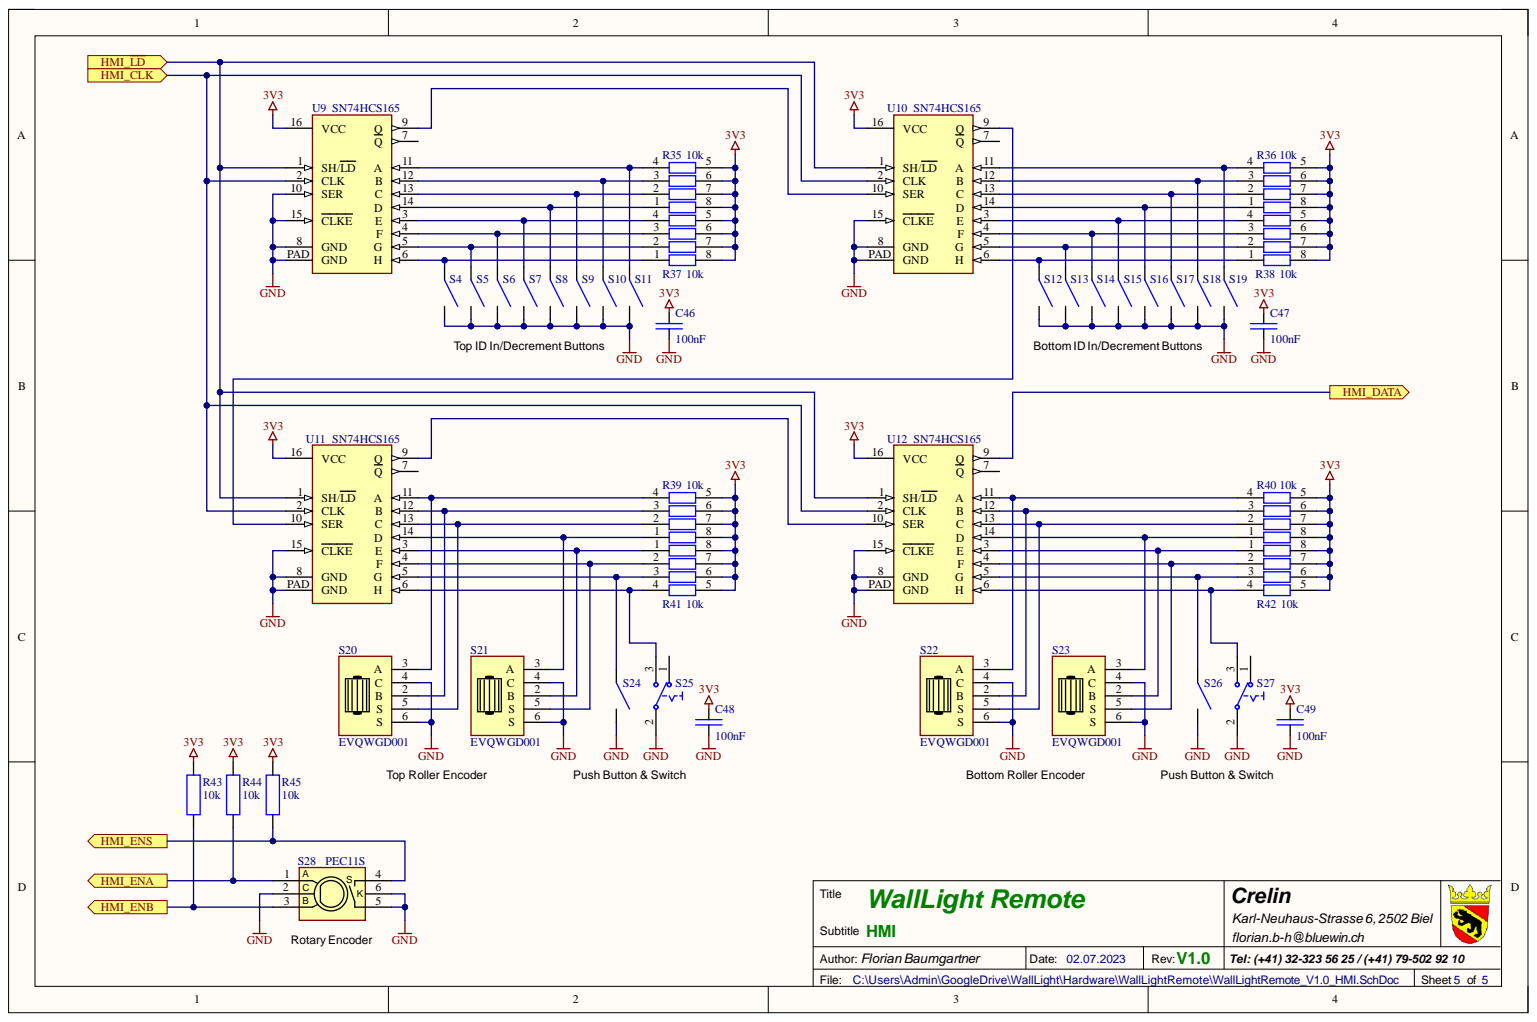
[picture p73: page 5]

Karl-Neuhaus-Strasse 6, 2502 Biel
florian.b-h@bluewin.ch

C:\Users\Admin\GoogleDrive\WallLight\Hardware\WallLightRemote\WallLightRemote_V1.0_HMI.SchDoc
File:

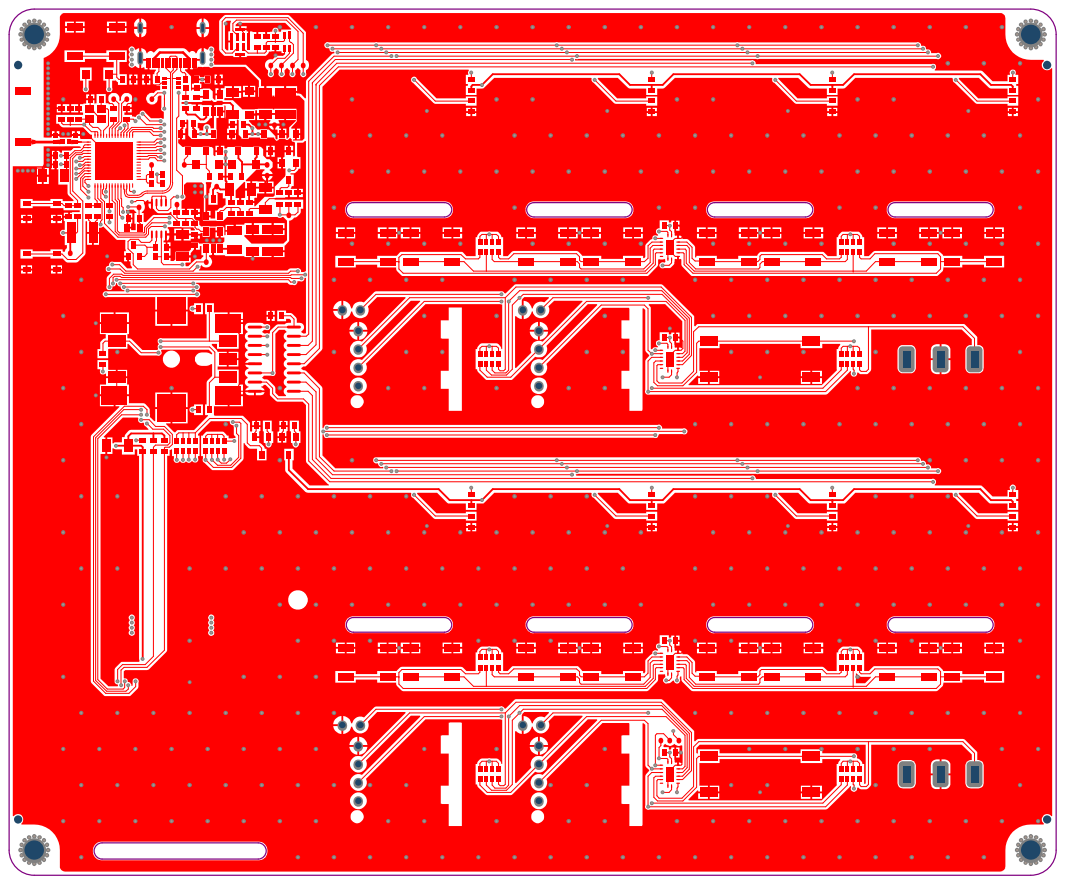
[picture p74: page 6]

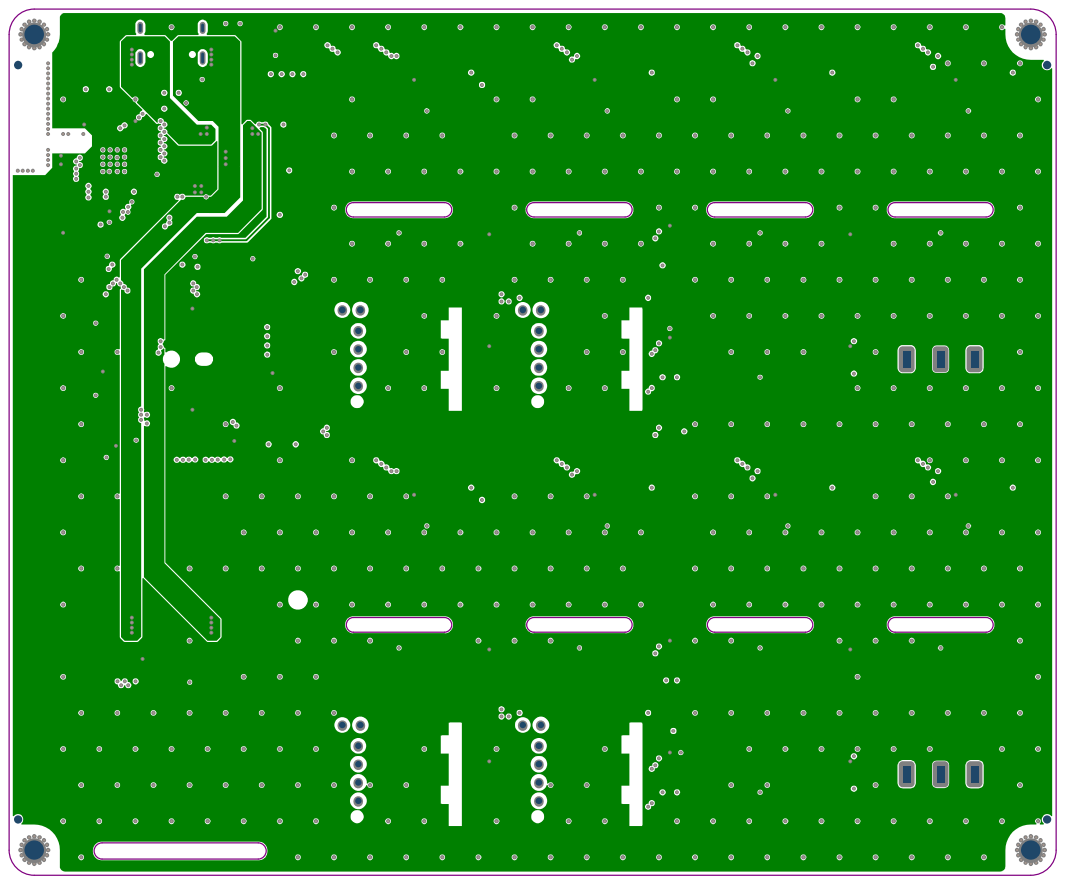
[picture p75: page 7]

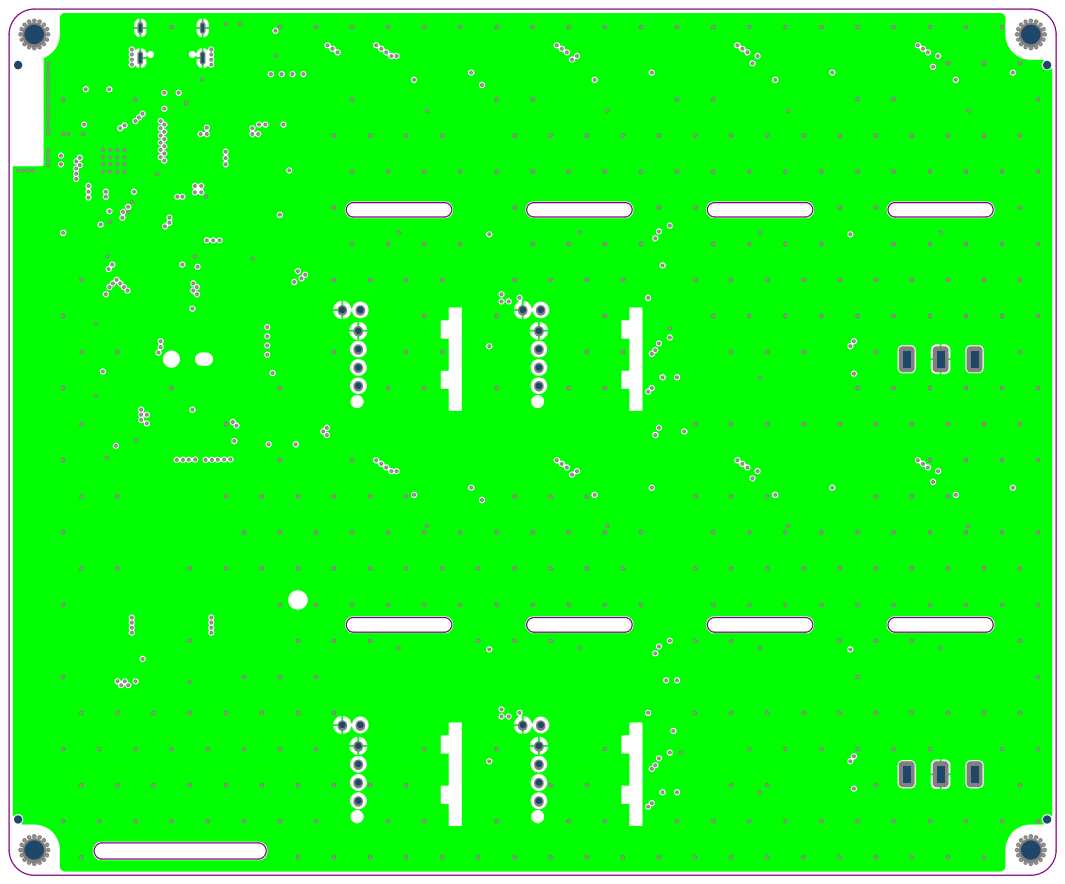
[picture p76: page 8]

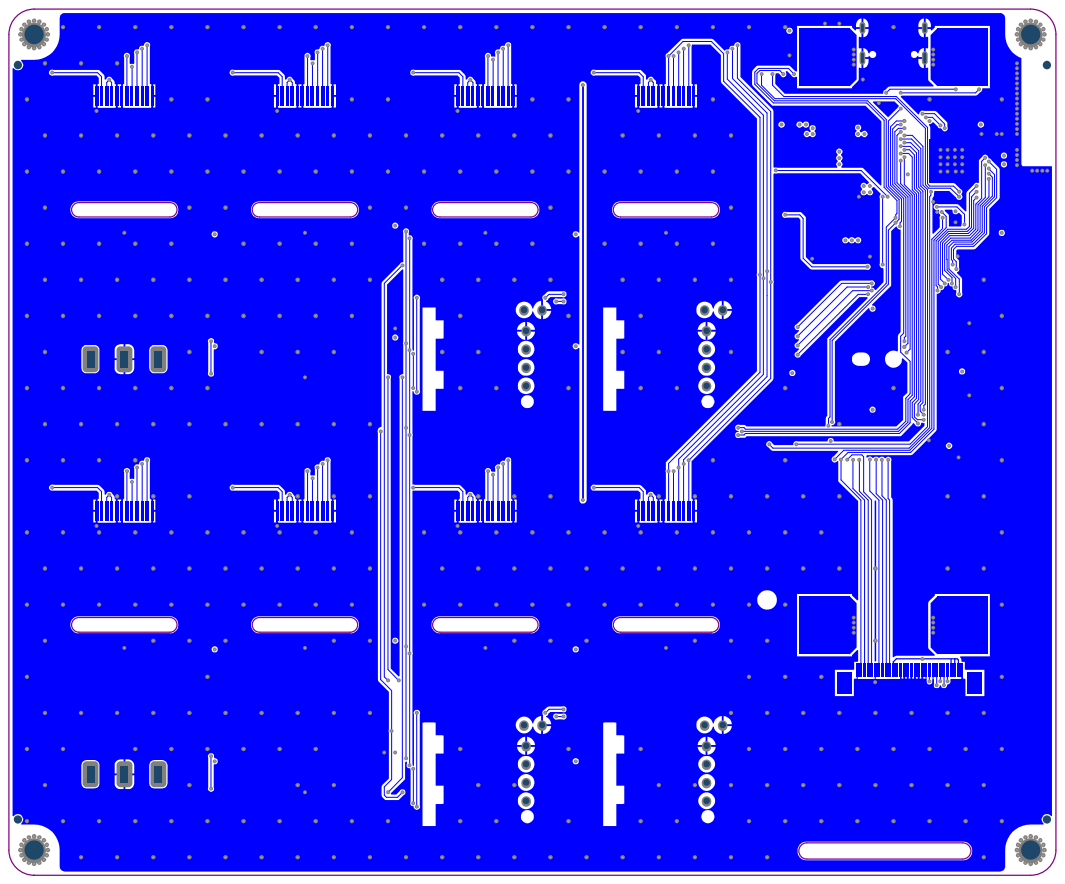
[picture p77: page 9]

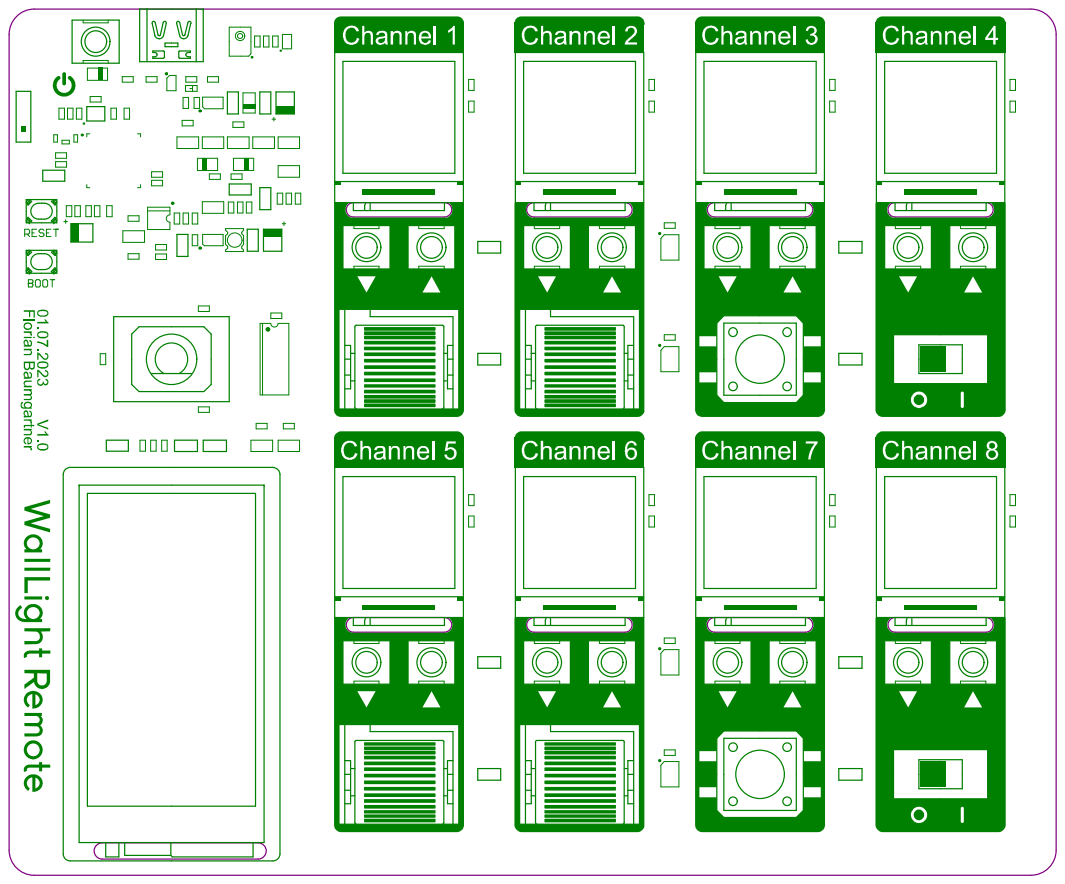
[picture p78: page 10]

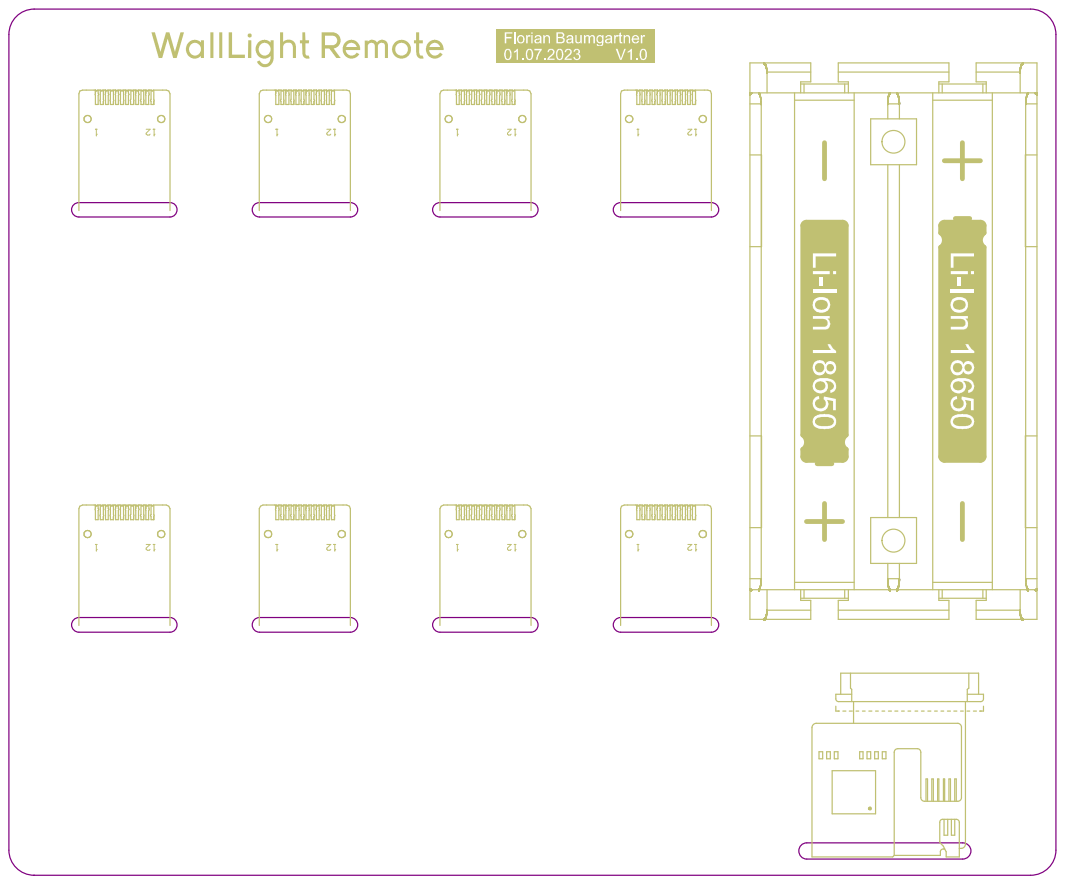
[picture p79: page 11]

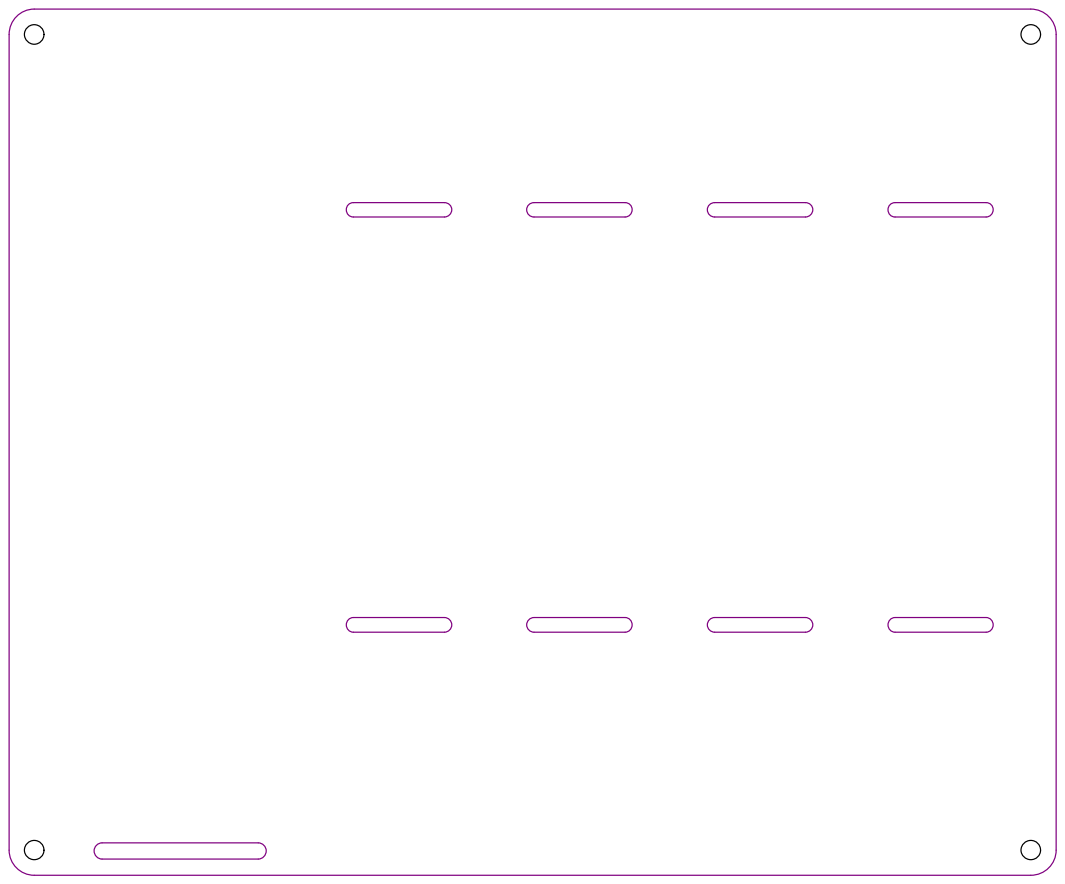
[picture p80: page 12]
