FlorianBaumgartner/WallLight/Software/Emulator/Demo/Demo_OnOff/Demo_OnOff.pdf

# Demo OnOff

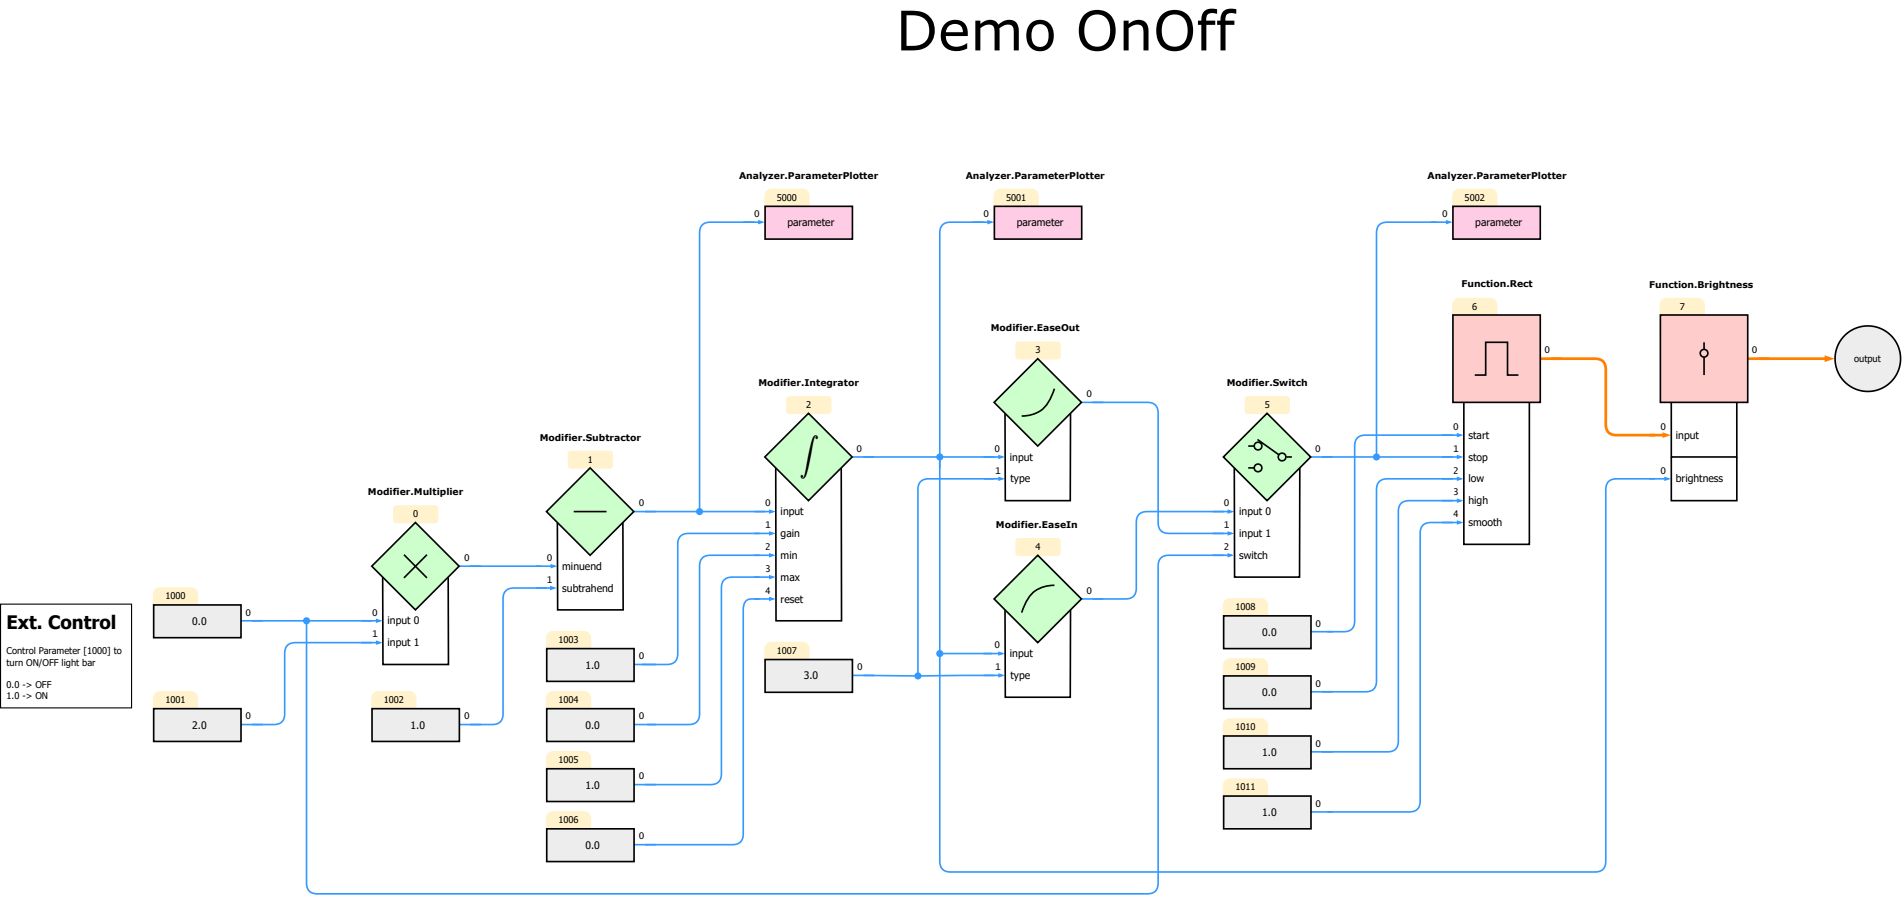
[picture p81: page 1]
input 0; input 1; Modifier.Multiplier; Analyzer.ParameterPlotter; Function.Rect; Modifier.EaseIn; Modifier.EaseOut; Modifier.Subtractor; Modifier.Integrator; Modifier.Switch; Function.Brightness; minuend; subtrahend; switch; input; type; gain; min; max; 4 reset ¹⁰⁰⁰; start; stop; low; high; smooth; brightness; parameter; output; Ext. Control; 0.0 -> OFF 1.0 -> ON

Control Parameter [1000] to
turn ON/OFF light bar
