FlorianBaumgartner/WallLight/Hardware/WallLightRemote/3D/SF-TC190B-8822A/SF-TC190B-8822A-CT1_Drawing_Back.pdf

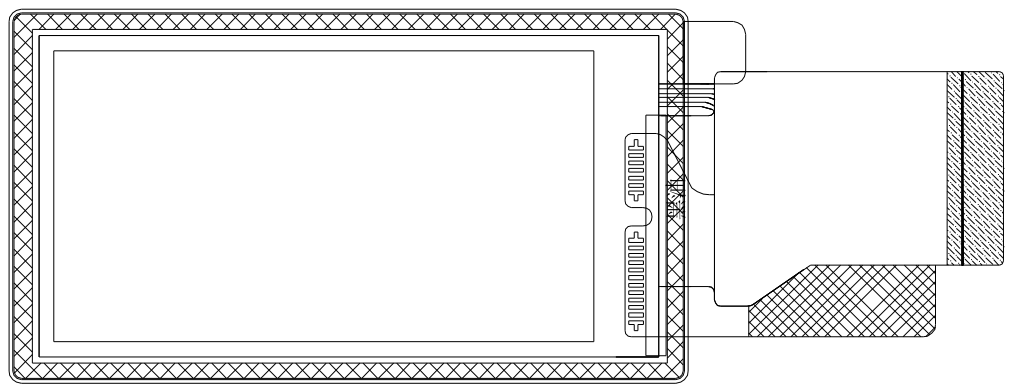
[picture p82: page 1]
