FlorianBaumgartner/WallLight/(list of files, drawings)

Other design files:
Hardware/WallLight/WallLight.PrjPcb
Hardware/WallLight/WallLight.SCHLIB
Hardware/WallLight/WallLight_V1.0.PcbDoc
Hardware/WallLight/WallLight_V1.0.SchDoc
Hardware/WallLightRemote/WallLightRemote.PcbLib
Hardware/WallLightRemote/WallLightRemote.PrjPcb
Hardware/WallLightRemote/WallLightRemote_V1.0.SchDoc
Hardware/WallLightRemote/WallLightRemote_V1.0_Displays.SchDoc
Hardware/WallLightRemote/WallLightRemote_V1.0_HMI.SchDoc
Hardware/WallLightRemote/WallLightRemote_V1.0_MCU.SchDoc
Hardware/WallLightRemote/WallLightRemote_V1.0_Power.SchDoc
