FlorianBaumgartner/WallLight/Firmware/WallLight/src/Engine/Function/FunctionColorWheel.hpp

/******************************************************************************
* file    FunctionColorWheel.hpp
*******************************************************************************
* brief   Color Wheel Function
*******************************************************************************
* author  Florian Baumgartner
* version 1.0
* date    2023-03-22
*******************************************************************************
* MIT License
*
* Copyright (c) 2023 Crelin - Florian Baumgartner
*
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
* THE SOFTWARE IS PROVIDED "AS IS", WITHOUT WARRANTY OF ANY KIND, EXPRESS OR
* IMPLIED, INCLUDING BUT NOT LIMITED TO THE WARRANTIES OF MERCHANTABILITY,
* FITNESS FOR A PARTICULAR PURPOSE AND NONINFRINGEMENT. IN NO EVENT SHALL THE
* AUTHORS OR COPYRIGHT HOLDERS BE LIABLE FOR ANY CLAIM, DAMAGES OR OTHER
* LIABILITY, WHETHER IN AN ACTION OF CONTRACT, TORT OR OTHERWISE, ARISING FROM,
* OUT OF OR IN CONNECTION WITH THE SOFTWARE OR THE USE OR OTHER DEALINGS IN THE
* SOFTWARE.
******************************************************************************/

#ifndef FUNCTION_COLOR_WHEEL_HPP
#define FUNCTION_COLOR_WHEEL_HPP

#include <Arduino.h>
#include "../Module.hpp"
#include "../Utility.hpp"

#define log   DISABLE_MODULE_LEVEL

class FunctionColorWheel: public virtual Function
{
  private:
    Parameter parameterInputs[4] = {Parameter("cycles", 1.0),
                                    Parameter("position", 0.0),
                                    Parameter("saturation", 1.0),
                                    Parameter("brightness", 1.0)};

    Parameter parameterOutputs [0] = {};   

    Vector inputs[0] = {};
    LedVector outputVectors[1] = {LedVector()};
    Vector outputs[1] = {Vector("output", &outputVectors[0])};

  public:
    static constexpr const char* MODULE_NAME = "ColorWheel";
    FunctionColorWheel(int32_t id): Function(id, MODULE_NAME) {}
    ~FunctionColorWheel() {}
    inline Parameter* getParameterInput(uint16_t index) {return (index < (sizeof(parameterInputs) / sizeof(Parameter)))? &parameterInputs[index] : nullptr;}
    inline Parameter* getParameterOutput(uint16_t index) {return (index < (sizeof(parameterOutputs) / sizeof(Parameter)))? &parameterOutputs[index] : nullptr;}
    inline uint32_t getParameterInputCount() {return (sizeof(parameterInputs) / sizeof(Parameter));}
    inline uint32_t getParameterOutputCount() {return (sizeof(parameterOutputs) / sizeof(Parameter));}
    inline Vector* getInput(uint16_t index) {return (index < (sizeof(inputs) / sizeof(Vector)))? &inputs[index] : nullptr;}
    inline Vector* getOutput(uint16_t index) {return (index < (sizeof(outputs) / sizeof(Vector)))? &outputs[index] : nullptr;}
    inline uint32_t getInputCount() {return (sizeof(inputs) / sizeof(Vector));}
    inline uint32_t getOutputCount() {return (sizeof(outputs) / sizeof(Vector));}

    bool init(bool deepCopy = false)
    {
      checkParameterInputs();         // Iterate over all parameter inputs to check if they are valid
      getOutput(0)->allocate(0.0);    // Always allocate an output vector for this module 
      return initDone();
    }

    bool update(float time)
    {
      if(t == time)                // Only calculate module content if time has updated
      {
        return true;
      }
      if(!Function::update(t))     // Check if all sources are available (modules that are connected have output value ready)
      {
        return false;
      }
      t = time;

      float cycles = getParameterValue(0);
      float pos = getParameterValue(1);
      float sat = getParameterValue(2);
      float bright = getParameterValue(3);

      LedVector* output = getOutputValue(0);
      if(LedVector::checkValid(output))
      {
        float r, g, b;
        for(int i = 0; i < pixelcount(); i++)
        {
          float hue = ((float)i / (float)pixelcount()) * cycles + pos;
          // console.printf("[COLORWHEEL] pos: %.2f, hue: %.2f\n", pos, hue);
          Utility::hsvToRgb(hue, sat, bright, &r, &g, &b);
          output->value[LED_R][i] = r;
          output->value[LED_G][i] = g;
          output->value[LED_B][i] = b;
          // TODO: Add Gamma Correction as described in: https://github.com/adafruit/Adafruit_NeoPixel/blob/master/Adafruit_NeoPixel.cpp
        }
      }
      else error = true;
      return true;
    }
};

#ifdef log
  #undef log
#endif
#endif
