FlorianBaumgartner/WallLight/Firmware/WallLight/src/Engine/Function/Function.hpp

/******************************************************************************
* file    Function.hpp
*******************************************************************************
* brief   List of all Function Modules
*******************************************************************************
* author  Florian Baumgartner
* version 1.0
* date    2023-02-18
*******************************************************************************
* MIT License
*
* Copyright (c) 2023 Crelin - Florian Baumgartner
*
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
* THE SOFTWARE IS PROVIDED "AS IS", WITHOUT WARRANTY OF ANY KIND, EXPRESS OR
* IMPLIED, INCLUDING BUT NOT LIMITED TO THE WARRANTIES OF MERCHANTABILITY,
* FITNESS FOR A PARTICULAR PURPOSE AND NONINFRINGEMENT. IN NO EVENT SHALL THE
* AUTHORS OR COPYRIGHT HOLDERS BE LIABLE FOR ANY CLAIM, DAMAGES OR OTHER
* LIABILITY, WHETHER IN AN ACTION OF CONTRACT, TORT OR OTHERWISE, ARISING FROM,
* OUT OF OR IN CONNECTION WITH THE SOFTWARE OR THE USE OR OTHER DEALINGS IN THE
* SOFTWARE.
******************************************************************************/

#ifndef FUNCTION_HPP
#define FUNCTION_HPP

#include <Arduino.h>
#include "../Module.hpp"
#include "../../console.hpp"

#include "FunctionRect.hpp"
#include "FunctionPulse.hpp"
#include "FunctionTriangle.hpp"
#include "FunctionRamp.hpp"
#include "FunctionDirac.hpp"
#include "FunctionBlank.hpp"
#include "FunctionColorGain.hpp"
#include "FunctionColorInsert.hpp"
#include "FunctionColorInterpolate.hpp"
#include "FunctionColorWheel.hpp"
#include "FunctionColorBlend.hpp"
#include "FunctionAdder.hpp"
#include "FunctionSubtractor.hpp"
#include "FunctionMultiplier.hpp"
#include "FunctionSum.hpp"
#include "FunctionProduct.hpp"
#include "FunctionSwitch.hpp"
#include "FunctionMixer.hpp"
#include "FunctionBrightness.hpp"
#include "FunctionPdf.hpp"
#include "FunctionFire.hpp"


static Function* allocateFunction(const char* name, int32_t id)
{
  Function* module = nullptr;
  if(strcmp(name, FunctionRect::MODULE_NAME) == 0)
  {
    module = new FunctionRect(id);
  }
  else if(strcmp(name, FunctionPulse::MODULE_NAME) == 0)
  {
    module = new FunctionPulse(id);
  }
  else if(strcmp(name, FunctionTriangle::MODULE_NAME) == 0)
  {
    module = new FunctionTriangle(id);
  }
  else if(strcmp(name, FunctionRamp::MODULE_NAME) == 0)
  {
    module = new FunctionRamp(id);
  }
  else if(strcmp(name, FunctionDirac::MODULE_NAME) == 0)
  {
    module = new FunctionDirac(id);
  }
  else if(strcmp(name, FunctionBlank::MODULE_NAME) == 0)
  {
    module = new FunctionBlank(id);
  }
  else if(strcmp(name, FunctionColorGain::MODULE_NAME) == 0)
  {
    module = new FunctionColorGain(id);
  }
  else if(strcmp(name, FunctionColorInsert::MODULE_NAME) == 0)
  {
    module = new FunctionColorInsert(id);
  }
  else if(strcmp(name, FunctionColorInterpolate::MODULE_NAME) == 0)
  {
    module = new FunctionColorInterpolate(id);
  }
  else if(strcmp(name, FunctionColorWheel::MODULE_NAME) == 0)
  {
    module = new FunctionColorWheel(id);
  }
  else if(strcmp(name, FunctionColorBlend::MODULE_NAME) == 0)
  {
    module = new FunctionColorBlend(id);
  }
  else if(strcmp(name, FunctionAdder::MODULE_NAME) == 0)
  {
    module = new FunctionAdder(id);
  }
  else if(strcmp(name, FunctionSubtractor::MODULE_NAME) == 0)
  {
    module = new FunctionSubtractor(id);
  }
  else if(strcmp(name, FunctionMultiplier::MODULE_NAME) == 0)
  {
    module = new FunctionMultiplier(id);
  }
  else if(strcmp(name, FunctionSum::MODULE_NAME) == 0)
  {
    module = new FunctionSum(id);
  }
  else if(strcmp(name, FunctionProduct::MODULE_NAME) == 0)
  {
    module = new FunctionProduct(id);
  }
  else if(strcmp(name, FunctionSwitch::MODULE_NAME) == 0)
  {
    module = new FunctionSwitch(id);
  }
  else if(strcmp(name, FunctionMixer::MODULE_NAME) == 0)
  {
    module = new FunctionMixer(id);
  }
  else if(strcmp(name, FunctionBrightness::MODULE_NAME) == 0)
  {
    module = new FunctionBrightness(id);
  }
  else if(strcmp(name, FunctionPdf::MODULE_NAME) == 0)
  {
    module = new FunctionPdf(id);
  }
  else if(strcmp(name, FunctionFire::MODULE_NAME) == 0)
  {
    module = new FunctionFire(id);
  }
  else
  {
    console.error.printf("[FUNCTION] Module '%s' is not supported!\n", name);
  }
  return module;
}

#endif
