FlorianBaumgartner/WallLight/Firmware/WallLightRemote/src/console.cpp

/******************************************************************************
* file    console.cpp
*******************************************************************************
* brief   Wrapper for Serial Debugging (threadsafe, buffered, colorized, etc.)
*******************************************************************************
* author  Florian Baumgartner
* version 1.0
* date    2022-08-02
*******************************************************************************
* MIT License
*
* Copyright (c) 2022 Crelin - Florian Baumgartner
*
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
* THE SOFTWARE IS PROVIDED "AS IS", WITHOUT WARRANTY OF ANY KIND, EXPRESS OR
* IMPLIED, INCLUDING BUT NOT LIMITED TO THE WARRANTIES OF MERCHANTABILITY,
* FITNESS FOR A PARTICULAR PURPOSE AND NONINFRINGEMENT. IN NO EVENT SHALL THE
* AUTHORS OR COPYRIGHT HOLDERS BE LIABLE FOR ANY CLAIM, DAMAGES OR OTHER
* LIABILITY, WHETHER IN AN ACTION OF CONTRACT, TORT OR OTHERWISE, ARISING FROM,
* OUT OF OR IN CONNECTION WITH THE SOFTWARE OR THE USE OR OTHER DEALINGS IN THE
* SOFTWARE.
******************************************************************************/

#include "console.hpp"

bool Console::begin(void)
{
  if(type == USBCDC_t)
  {
    (*(USBCDC*)&stream).enableReboot(true);     // Enables entering bootloader when changing to baudrate of 1200 bit/s (normaly not used, due to dedicated DFU USB-Endpoint)
    (*(USBCDC*)&stream).onEvent(usbEventCallback);
    (*(USBCDC*)&stream).begin();
  }
  else return false;
  return initialize();
}

bool Console::begin(unsigned long baud, uint32_t config, int8_t rxPin, int8_t txPin, bool invert, unsigned long timeout_ms, uint8_t rxfifo_full_thrhd)
{
  if(type == HardwareSerial_t)
  {
    (*(HardwareSerial*)&stream).begin(baud, config, rxPin, txPin, invert, timeout_ms, rxfifo_full_thrhd);
  }
  else return false;
  return initialize();
}

bool Console::initialize(void)
{
  initialized = true;
  bufferAccessSemaphore = xSemaphoreCreateMutex();
  xTaskCreate(writeTask, "task_consoleWrite", 4096, this, 2, &writeTaskHandle);
  xTaskCreate(interfaceTask, "task_consoleIface", 4096, this, 3, nullptr);    // TODO: Stack size must be that large?!
  return true;
}

void Console::end(void)
{
  initialized = false;
}

void Console::writeTask(void *pvParameter)
{
  Console* ref = (Console*)pvParameter;

  while(ref->initialized)
  {
    ulTaskNotifyTake(pdTRUE, portMAX_DELAY);          // Wait on notification for data in buffer or console opened
    if(ref->streamActive)
    {
      if(xSemaphoreTake(ref->bufferAccessSemaphore, portMAX_DELAY))
      {
        if(ref->readIdx < ref->writeIdx)              // Regular case, no wrap around needed
        {
          ref->stream.write((const uint8_t*) ref->ringBuffer + ref->readIdx, ref->writeIdx - ref->readIdx);
        }
        else if(ref->readIdx > ref->writeIdx)         // Need to send buffer in two parts (ReadIdx to End | 0 to WriteIdx)
        {
          ref->stream.write((const uint8_t*) ref->ringBuffer + ref->readIdx, QUEUE_BUFFER_LENGTH - ref->readIdx);
          ref->stream.write((const uint8_t*) ref->ringBuffer, ref->writeIdx);
        }
        ref->readIdx = ref->writeIdx;
        xSemaphoreGive(ref->bufferAccessSemaphore);
      }
    }
  }
  vTaskDelete(NULL);
}

void Console::interfaceTask(void *pvParameter)
{
  Console* ref = (Console*)pvParameter;

  TickType_t interfaceTimer = 0;
  TickType_t enabledTimer = 0;
  bool enabledOld = false, enabledDelayed = false;
  bool interfaceOld = false, interfaceDelayed = false;
  bool streamActiveOld = false;
  while(ref->initialized)
  {
    TickType_t task_last_tick = xTaskGetTickCount();

    if(ref->enabled && !enabledOld)
    {
      enabledTimer = xTaskGetTickCount() + CONSOLE_ACTIVE_DELAY;
    }
    enabledOld = ref->enabled;
    enabledDelayed = (xTaskGetTickCount() > enabledTimer) && ref->enabled;

    if(ref->getInterfaceState() && !interfaceOld)
    {
      interfaceTimer = xTaskGetTickCount() + INTERFACE_ACTIVE_DELAY;
    }
    interfaceOld = ref->getInterfaceState();
    interfaceDelayed = (xTaskGetTickCount() > interfaceTimer) && ref->getInterfaceState();

    ref->streamActive = enabledDelayed && interfaceDelayed;
    if(ref->streamActive && !streamActiveOld)
    {
      ref->printStartupMessage();
      vTaskDelay((const TickType_t) 10);                    // Make sure that startup message is printed befor everything else
      xTaskNotifyGive(ref->writeTaskHandle);                // Send signal to update task (for sending out data in queue buffer)
    }
    if(!ref->streamActive && streamActiveOld)               // Detect if console has been closed
    {
      ref->stream.flush();
      ref->stream.clearWriteError();
    }
    streamActiveOld = ref->streamActive;

    vTaskDelayUntil(&task_last_tick, (const TickType_t) 1000 / INTERFACE_UPDATE_RATE);
  }
  vTaskDelete(NULL);
}

size_t Console::write(const uint8_t *buffer, size_t size)
{
  if(size == 0) return 0;
  if(xSemaphoreTake(bufferAccessSemaphore, portMAX_DELAY))
  {
    int free;
    size = min(size, (size_t) QUEUE_BUFFER_LENGTH - 1);
    if(writeIdx + size <= QUEUE_BUFFER_LENGTH)
    {
      memcpy((uint8_t*) ringBuffer + writeIdx, buffer, size);
      free = QUEUE_BUFFER_LENGTH - (writeIdx - readIdx);
    }
    else
    {
      int firstPartSize = QUEUE_BUFFER_LENGTH - writeIdx;
      memcpy((uint8_t*) ringBuffer + writeIdx, buffer, firstPartSize);
      memcpy((uint8_t*) ringBuffer, buffer + firstPartSize, size - firstPartSize);
      free = readIdx - writeIdx;
    } 
    writeIdx = (writeIdx + size) & (QUEUE_BUFFER_LENGTH - 1);
    if(size > free)
    {
      readIdx = (readIdx + (size - free)) & (QUEUE_BUFFER_LENGTH - 1);
    }

    xSemaphoreGive(bufferAccessSemaphore);
    xTaskNotifyGive(writeTaskHandle);               // Send signal to update task (for sending out data)
    return size;
  }
  return 0;
}

void Console::printTimestamp(void)
{
  int h = _min(millis() / 3600000, 99);
  int m = (millis() / 60000) % 60;
  int s = (millis() / 1000) % 60;
  int ms = millis() % 1000;
  printf("[%02d:%02d:%02d.%03d] ", h, m, s, ms);
}

void Console::printStartupMessage(void)
{
  stream.print(CONSOLE_CLEAR);
  stream.print(CONSOLE_COLOR_BOLD_CYAN CONSOLE_BACKGROUND_DEFAULT);
  stream.println("****************************************************");
  stream.println("*                  WallLight-Remote                *");
  stream.println("*             2023, Florian Baumgartner            *");
  stream.println("****************************************************");
  stream.println(CONSOLE_LOG);
}

void Console::usbEventCallback(void* arg, esp_event_base_t event_base, int32_t event_id, void* event_data)
{
  if(event_base == ARDUINO_USB_CDC_EVENTS)
  {
    arduino_usb_cdc_event_data_t * data = (arduino_usb_cdc_event_data_t*)event_data;
    switch (event_id)
    {
      case ARDUINO_USB_CDC_CONNECTED_EVENT:
        break;
      case ARDUINO_USB_CDC_DISCONNECTED_EVENT:
        break;
      case ARDUINO_USB_CDC_LINE_STATE_EVENT:
        break;
      case ARDUINO_USB_CDC_LINE_CODING_EVENT:
        break;
      default:
        break;
    }
  }
}


#ifndef USE_CUSTOM_CONSOLE
  USBCDC USBSerial;
  Console console(USBSerial);
#endif
