FlorianBaumgartner/WallLight/Software/WallLightTest/WallLightTest.h

#ifndef WALLLIGHT_TEST_H
#define WALLLIGHT_TEST_H

#include <QMainWindow>
#include <QTimer>
#include <QPainter>
#include <QColor>
#include <QPixmap>
#include <QLabel>

#include "Test/TestEngine.hpp"

#include "../../Firmware/WallLight/src/Engine/WallLightConfig.hpp"
#include "../../Firmware/WallLight/src/Engine/DataTypes.hpp"

namespace Ui {
class WallLightTest;
}

class WallLightTest : public QMainWindow
{
    Q_OBJECT

  public:
    explicit WallLightTest(QWidget *parent = 0);
    ~WallLightTest();

    static const int WINDOW_WIDTH = 230;
    static const int WINDOW_HEIGHT = 1000;
    static const int PIXELS_OFFSET = 50;
    static const int PIXELS_WWA_OFFSET = 50;
        
    static const int FRAMERATE = 50;
    static const int PIXELCOUNT = 288;

    bool loadGraph(const char* name);
    void unloadGraph();    

  private slots:
    void on_actionExit_triggered();
    void changeColors(void);

  private:
    Ui::WallLightTest *ui;
    QTimer* timer;
    QPixmap* pixmap;
    QLabel* label;

    Engine* engine;
    TestEngine* testEngine;
    LedVector* output = nullptr;
    bool running = false;
    bool unloadingGraphPending = false;
};

#endif // WALLLIGHT_TEST_H
