FlorianBaumgartner/WallLight/Software/WallLightTest/Test/Modifier/TestModifier.hpp

/******************************************************************************
* file    TestModifier.hpp
*******************************************************************************
* brief   Virtual base class of all modifier tests
*******************************************************************************
* author  Florian Baumgartner
* version 1.0
* date    2023-04-07
*******************************************************************************
* MIT License
*
* Copyright (c) 2023 Crelin - Florian Baumgartner
*
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
* THE SOFTWARE IS PROVIDED "AS IS", WITHOUT WARRANTY OF ANY KIND, EXPRESS OR
* IMPLIED, INCLUDING BUT NOT LIMITED TO THE WARRANTIES OF MERCHANTABILITY,
* FITNESS FOR A PARTICULAR PURPOSE AND NONINFRINGEMENT. IN NO EVENT SHALL THE
* AUTHORS OR COPYRIGHT HOLDERS BE LIABLE FOR ANY CLAIM, DAMAGES OR OTHER
* LIABILITY, WHETHER IN AN ACTION OF CONTRACT, TORT OR OTHERWISE, ARISING FROM,
* OUT OF OR IN CONNECTION WITH THE SOFTWARE OR THE USE OR OTHER DEALINGS IN THE
* SOFTWARE.
******************************************************************************/

#ifndef TEST_MODIFIER_HPP
#define TEST_MODIFIER_HPP

#include "../TestEngine.hpp"

#include "TestModifierAdder.hpp"
#include "TestModifierSubtractor.hpp"
#include "TestModifierMultiplier.hpp"
#include "TestModifierSum.hpp"
#include "TestModifierProduct.hpp"
#include "TestModifierMixer.hpp"
#include "TestModifierSwitch.hpp"
#include "TestModifierAbs.hpp"
#include "TestModifierConstrain.hpp"
#include "TestModifierEaseIn.hpp"
#include "TestModifierEaseOut.hpp"
#include "TestModifierEaseInOut.hpp"
#include "TestModifierIntegrator.hpp"
#include "TestModifierDifferentiator.hpp"
#include "TestModifierExpSmoothing.hpp"
#include "TestModifierSampler.hpp"
#include "TestModifierMonoflop.hpp"
#include "TestModifierHsvToRgb.hpp"
#include "TestModifierRgbToHsv.hpp"
#include "TestModifierNegate.hpp"
#include "TestModifierInvert.hpp"


static bool testModifier(Engine* engine, const char* name)
{
  if(strcmp(name, TestModifierAdder::TEST_NAME) == 0)
  {
    return TestModifierAdder::test(engine);
  }
  else if(strcmp(name, TestModifierSubtractor::TEST_NAME) == 0)
  {
    return TestModifierSubtractor::test(engine);
  }
  else if(strcmp(name, TestModifierMultiplier::TEST_NAME) == 0)
  {
    return TestModifierMultiplier::test(engine);
  }
  else if(strcmp(name, TestModifierSum::TEST_NAME) == 0)
  {
    return TestModifierSum::test(engine);
  }
  else if(strcmp(name, TestModifierProduct::TEST_NAME) == 0)
  {
    return TestModifierProduct::test(engine);
  }
  else if(strcmp(name, TestModifierMixer::TEST_NAME) == 0)
  {
    return TestModifierMixer::test(engine);
  }
  else if(strcmp(name, TestModifierSwitch::TEST_NAME) == 0)
  {
    return TestModifierSwitch::test(engine);
  }
  else if(strcmp(name, TestModifierAbs::TEST_NAME) == 0)
  {
    return TestModifierAbs::test(engine);
  }
  else if(strcmp(name, TestModifierConstrain::TEST_NAME) == 0)
  {
    return TestModifierConstrain::test(engine);
  }
  else if(strcmp(name, TestModifierEaseIn::TEST_NAME) == 0)
  {
    return TestModifierEaseIn::test(engine);
  }
  else if(strcmp(name, TestModifierEaseOut::TEST_NAME) == 0)
  {
    return TestModifierEaseOut::test(engine);
  }
  else if(strcmp(name, TestModifierEaseInOut::TEST_NAME) == 0)
  {
    return TestModifierEaseInOut::test(engine);
  }
  else if(strcmp(name, TestModifierIntegrator::TEST_NAME) == 0)
  {
    return TestModifierIntegrator::test(engine);
  }
  else if(strcmp(name, TestModifierDifferentiator::TEST_NAME) == 0)
  {
    return TestModifierDifferentiator::test(engine);
  }
  else if(strcmp(name, TestModifierExpSmoothing::TEST_NAME) == 0)
  {
    return TestModifierExpSmoothing::test(engine);
  }
  else if(strcmp(name, TestModifierSampler::TEST_NAME) == 0)
  {
    return TestModifierSampler::test(engine);
  }
  else if(strcmp(name, TestModifierMonoflop::TEST_NAME) == 0)
  {
    return TestModifierMonoflop::test(engine);
  }
  else if(strcmp(name, TestModifierHsvToRgb::TEST_NAME) == 0)
  {
    return TestModifierHsvToRgb::test(engine);
  }
  else if(strcmp(name, TestModifierRgbToHsv::TEST_NAME) == 0)
  {
    return TestModifierRgbToHsv::test(engine);
  }
  else if(strcmp(name, TestModifierNegate::TEST_NAME) == 0)
  {
    return TestModifierNegate::test(engine);
  }
  else if(strcmp(name, TestModifierInvert::TEST_NAME) == 0)
  {
    return TestModifierInvert::test(engine);
  }
  else
  {
    console.error.printf("[TEST_MODIFIER] Modifier '%s' is not supported!\n", name);
  }
  return false;
}

#endif
