FlorianBaumgartner/WallLight/(commit log)

2022-12-24 Added further modules
    [in.csv, out.csv, out2.csv]
2023-01-03 Added empty ESP32-S3 based project
    [partitions_custom.csv]
2023-01-26 Added Ambilight Demo (Framerate increasing required!)
2023-01-29 Added Modules: ColorVector, Modifier.Sampler, Modifier.Monoflop
2023-02-14 Added Firmware Framework
2023-02-14 Added LED DMA Example
2023-02-26 Try to fix update issues
    [Function.h, FunctionColorGain.h, FunctionRect.h, FunctionTriangle.h]
2023-03-04 Fixed vector allocation bugs
    [FunctionAdder.hpp, FunctionColorGain.hpp, FunctionRect.hpp, FunctionSum.hpp, FunctionTriangle.hpp]
2023-03-04 Fixed Timing issues in emulator
    [FunctionRect.hpp, FunctionSum.hpp, main.cpp]
2023-03-08 Working on module deallocation process (deinitialization is still buggy)
    [Function.hpp, FunctionAdder.hpp, FunctionColorGain.hpp, FunctionRect.hpp]
2023-03-18 Added Qt Test Framework
2023-03-19 Added Arduino Support to Qt Test Environment
2023-03-19 Added LedVector Support
2023-03-20 Fixed Generator Bugs (phase)
    [console.hpp]
2023-03-21 Fixed Bugs in makefile
    [FunctionSwitch.hpp, console.cpp, console.hpp]
2023-03-22 Made Led-Count and Framerate dynamic
2023-04-07 Added color interpolation modules and fixed bug in RGB->HSV Converter
    [Function.hpp, FunctionColorInterpolate.hpp]
2023-04-09 Added modifier modules and fixed output buffer zero-filling bug in some functions
    [FunctionAdder.hpp, FunctionColorInterpolate.hpp, FunctionMixer.hpp, FunctionMultiplier.hpp, FunctionProduct.hpp]
2023-04-09 Added further Modifier Modules and fixed LED-Flicker startup bug
    [FunctionFire.hpp, Modifier.hpp, ModifierMixer.hpp, ModifierSwitch.hpp, TestModifierMixer.hpp, TestModifierSwitch.hpp]
2023-04-10 Added further Modifier Modules and fixed bugs in Integrator/Differentiator Module
    [Modifier.hpp, ModifierDifferentiator.hpp]
2023-04-12 Fixed graph unloading race condition
    [main.cpp]
2023-04-15 Fixed Minot Bugs -> Conclusion: RGBW and RGB Strips cannot be used at the same time
    [ModifierMultiplier.hpp, WallLightTest.cpp]
2023-05-07 Added new Examples
    [partitions_custom.csv]
2023-05-13 Added LVGL Example
    [partitions_custom.csv]
2023-05-13 First working prototype
2023-05-14 Fixed Screen flicker issues
    [partitions_custom.csv]
2023-05-17 Removed History Files
    [WallLightRemote.PrjPcb, WallLightRemote.SCHLIB, WallLightRemote_V1.0.SchDoc, WallLightRemote_V1.0_HMI.SchDoc, WallLightRemote_V1.0_MCU.SchDoc, WallLightRemote_V1.0_Power.SchDoc]
2023-05-19 Finished Schematics
    [OBJ_NEW_PCB.obj, WallLightRemote.PcbLib, WallLightRemote.PrjPcb, WallLightRemote.SCHLIB, WallLightRemote_V1.0.SchDoc, WallLightRemote_V1.0_Displays.SchDoc, WallLightRemote_V1.0_HMI.SchDoc, WallLightRemote_V1.0_MCU.SchDoc]
2023-07-02 Added Final PCB of WallLight Remote
    [20436_ACF-050-30-C-CMS-H.SLDASM, 20436_ACF-050-30-C-CMS-H.stp, 2520 SMD Crystal Oscillator.x_b, 742843122.SLDPRT, 742843122.x_t, 84593 VEML6040.SLDPRT, 84593 VEML6040.stp, 84593 VEML6040.x_t]
2023-07-22 Started WallLightRemote Firmware
    [SF-TC190B-8822A.SLDASM, Spacer.SLDPRT, Spacer.STL, Spacer.x_t, WallLightRemote_V1.0_Displays.SchDoc, partitions_custom.csv]
2023-07-23 Added HMI Support
    [WallLightRemote.PrjPcb]
2023-07-29 Finished HMI Support
    [WallLightRemote_V1.0_Displays.SchDoc]
2023-07-29 Fixed Bootup-Crash caused by LVGL initialized twice
    [guiDsa.cpp, guiDsa.hpp, guiDsm.cpp, guiDsm.hpp, guiLvgl.hpp, main.cpp]
2023-07-31 Fixed Touch-Screen Driver
2023-07-31 Added support for Ambient Light Sensor
2023-08-03 Fixed I2C Race condition of Touch and Ambient-Color-Sensor
    [ambientSensor.cpp, ambientSensor.hpp, guiDsm.cpp, guiDsm.hpp, main.cpp]
2023-08-06 Added Power-Management Support
2023-08-06 Fixed display update glitches by adding semaphore to display write function
    [guiDsa.cpp, guiDsa.hpp, guiDsm.cpp, guiDsm.hpp]
2023-11-06 Updated Repo to newest state
    [Pick Place for WallLightRemote_V1.0.csv]
2023-11-22 Fixed Engine Bug
    [7790.step, WallLight.PrjPcb, WallLight.SCHLIB, WallLight_V1.0.PcbDoc, WallLight_V1.0.SchDoc]
2024-01-29 Added ESP32-S3 Debug Testcode
